beagleboard/capes/beaglebone/Comms/BeagleBoneCommsCapeA2_Top.png

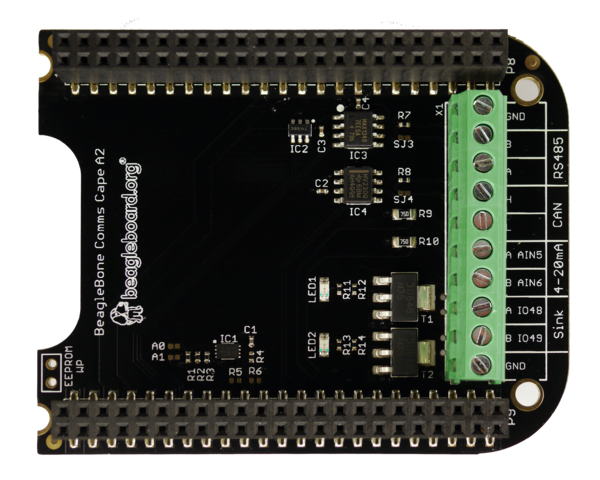
beaglebone/Comms/BeagleBoneCommsCapeA2_Top.png
