beagleboard/capes/README.md

| Cape | Manufacturer | Status |
|---|---|---|
| [Robotics](designs/Robotics) | Element14 | [production](http://beagleboard.org/RoboticsCape/) |
| [CAN_RS485](designs/CAN_RS485) | GHI Electronics | prototype |
| [Relay](designs/Relay) | GHI Electronics | prototype |
| [Load](designs/Load) | GHI Electronics | prototype |
| [Proto](designs/Proto) | GHI Electronics | prototype |
| [Power](designs/Power) | GHI Electronics | prototype |
| [Display18](designs/Display18) | GHI Electronics | prototype |
| [Display43](designs/Display43) | GHI Electronics | development |
| [Display70](designs/Display70) | GHI Electronics | development |
| [Motor](designs/Motor) | GHI Electronics | development |
