beagleboard/capes/beaglebone/Robotics/README.txt

This repository contains documentation of the physical Robotics Cape PCB design.

For instructions on using the support software and EduMiP, please visit:
https://beagleboard.org/librobotcontrol

Original source: https://github.com/StrawsonDesign/Robotics_Cape_Documentation
