beagleboard/capes/scripts/am335x-beagle-pins.csv

Board or signal detail | Manufacturer(s) | ID | Version | Addr | Status | Signal
[https://github.com/beagleboard/beaglebone-black BeagleBone Black] | Element14 / GHI Electronics | BNLT | 00C0 | 50 | [https://beagleboard.org/black production] | P8.01 / P8.02 / P9.01 / P9.02 / P9.43 / P9.44 / P9.45 / P9.46 | P8.03 / eMMC d6 | P8.04 / eMMC d7 | P8.05 / eMMC d2 | P8.06 / eMMC d3 | P8.07 | P8.08 | P8.09 | P8.10 | P8.11 | P8.12 | P8.13 | P8.14 | P8.15 | P8.16 | P8.17 | P8.18 | P8.19 | P8.20 / eMMC cmd | P8.21 / eMMC clk | P8.22 / eMMC d5 | P8.23 / eMMC d4 | P8.24 / eMMC d1 | P8.25 / eMMC d0 | P8.26 | P8.27 / hdmi | P8.28 / hdmi | P8.29 / hdmi | P8.30 / hdmi | P8.31 / hdmi / sysboot 14 | P8.32 / hdmi / sysboot 15 | P8.33 / hdmi / sysboot 13 | P8.34 / hdmi / sysboot 11 | P8.35 / hdmi / sysboot 12 | P8.36 / hdmi / sysboot 10 | P8.37 / hdmi / sysboot 8 | P8.38 / hdmi / sysboot 9 | P8.39 / hdmi / sysboot 6 | P8.40 / hdmi / sysboot 7 | P8.41 / hdmi / sysboot 4 | P8.42 / hdmi / sysboot 5 | P8.43 / hdmi / sysboot 2 | P8.44 / hdmi / sysboot 3 | P8.45 / hdmi / sysboot 0 | P8.46 / hdmi / sysboot 1 | P9.03 / P9.04 | P9.05 / P9.06 / VDD_5V | P9.07 / P9.08 / SYS_5V | P9.09 | P9.10 / -reset | P9.11 | P9.12 | P9.13 | P9.14
[https://github.com/beagleboard/beaglebone-black-wireless BeagleBone Black Wireless] | GHI Electronics | BNLT | BWA5 | 50 | [https://beagleboard.org/black-wireless production] | P8.01 / P8.02 / P9.01 / P9.02 / P9.43 / P9.44 / P9.45 / P9.46 | P8.03 / eMMC d6 | P8.04 / eMMC d7 | P8.05 / eMMC d2 | P8.06 / eMMC d3 | P8.07 | P8.08 | P8.09 | P8.10 | P8.11 | P8.12 | P8.13 | P8.14 | P8.15 | P8.16 | P8.17 | P8.18 | P8.19 | P8.20 / eMMC cmd | P8.21 / eMMC clk | P8.22 / eMMC d5 | P8.23 / eMMC d4 | P8.24 / eMMC d1 | P8.25 / eMMC d0 | P8.26 | P8.27 / hdmi | P8.28 / hdmi | P8.29 / hdmi | P8.30 / hdmi | P8.31 / hdmi / sysboot 14 | P8.32 / hdmi / sysboot 15 | P8.33 / hdmi / sysboot 13 | P8.34 / hdmi / sysboot 11 | P8.35 / hdmi / sysboot 12 | P8.36 / hdmi / sysboot 10 | P8.37 / hdmi / sysboot 8 | P8.38 / hdmi / sysboot 9 | P8.39 / hdmi / sysboot 6 | P8.40 / hdmi / sysboot 7 | P8.41 / hdmi / sysboot 4 | P8.42 / hdmi / sysboot 5 | P8.43 / hdmi / sysboot 2 | P8.44 / hdmi / sysboot 3 | P8.45 / hdmi / sysboot 0 | P8.46 / hdmi / sysboot 1 | P9.03 / P9.04 | P9.05 / P9.06 / VDD_5V | P9.07 / P9.08 / SYS_5V | P9.09 | P9.10 / -reset | P9.11 | P9.12 | P9.13 | P9.14
[https://github.com/beagleboard/beaglebone-blue BeagleBone Blue] | Element14 | BNLT | BLA2 | 50 | [https://beagleboard.org/blue production] | UT0_1 / UT1_1 / UT5_1 / CAN_1 / DSM2_2 / I2C_1 / GP0_1 / GP1_1 / GPS_2 / GPS_6 / S1.1_1 / S1.2_1 / E1_1 / E2_1 / E3_1 / E4_1 / PWR_1 / PWR_2 / GND | -eMMC_DAT6 | -eMMC_DAT7 | -eMMC_DAT2 | -eMMC_DAT3 | RED | GREEN | PAUSE | MODE | E3_4 / EQEP_2B | E3_3 / EQEP_2A | MPWM_4 | BAT100 | E4_4 | E4_3 | BAT25 |  | MPWM_3 | -eMMC_CMD | -eMMC_CLK | -eMMC_DAT5 | -eMMC_DAT4 | -eMMC_DAT1 | -eMMC_DAT0 | BAT75 | SERVO_1 | SERVO_2 | SERVO_3 | SERVO_4 |  | BAT50 | E2_4 / EQEP_1B | MDIR_2B | E2_3 / EQEP_1A | SERVO_PWR_EN | UT5_4 / UART5_TX | UT5_3 / UART5_RX | SERVO_5 | SERVO_6 | SERVO_7 | SERVO_8 | MDIR_3B | MDIR_3A | MDIR_4A | MDIR_4B | UT0_2 / UT1_2 / UT5_2 / CAN_2 / DSM2_1 / I2C_2 / GP0_2 / GP1_2 / S1.1_2 / S1.2_2 / E1_2 / E2_2 / E3_2 / E4_2 / PWR_3 / 3.3V |  | PWR_4 / GPS_5 / 5.0V | POWER_BTN | RESET | DSM_3 / UART4_RX |  | MDIR_1B | MPWM_1
[https://github.com/beagleboard/pocketbeagle PocketBeagle] | GHI Electronics | PBGL | 00A2 | 50 | [https://beagleboard.org/pocket production] | P1.15 / P1.16 / P1.22 / P2.15 / P2.21 / GND |  |  |  |  |  |  | EEPROM-WP / GPIO69 |  | P2.33 / GPIO45 | P2.24 / GPIO44 | P2.03 / GPIO23 | P1.34 / GPIO26 | P2.18 / GPIO47 | P2.22 / GPIO46 | P2.19 / GPIO27 | P2.17 / GPIO65 |  |  |  |  |  |  |  |  | P2.35 / AIN5 / GPIO86 | P1.35 / PRU1.10 | P1.02 / AIN6 / GPIO87 | P1.04 / PRU1.11 | sysboot 14 | sysboot 15 | sysboot 13 | sysboot 11 | sysboot 12 | sysboot 10 | sysboot 8 | sysboot 9 | sysboot 6 | sysboot 7 | sysboot 4 | sysboot 5 | sysboot 2 | sysboot 3 | sysboot 0 | sysboot 1 | P1.14 / P2.23 / VOUT-3.3V | P1.01 / VIN | P1.24 / P2.13 / VOUT-5V | P2.12 / POWER_BTN | P2.26 / NRESET | P2.05 / UART4_RX | P2.08 / GPIO60 | P2.07 / UART4_TX | P2.01 / PWM1A
[https://github.com/beagleboard/capes/blob/master/designs/Comms Comms Cape] | GHI Electronics | BBORG_COMMS | 00A2 | 56 | prototype | GND |  |  |  |  |  |  |  |  |  |  |  |  |  |  |  |  |  |  |  |  |  |  |  |  |  |  |  |  |  |  |  |  |  |  |  |  |  |  |  |  |  |  |  |  | VCC | +5 | SYS.VOUT |  |  | RS485.RX / UART4 RX | RS485.TX / UART4 TX
[https://github.com/beagleboard/capes/blob/master/designs/Display18 Display 1.8” Cape] | GHI Electronics | BBORG_DISPLAY18 | 00A2 | 57 | prototype | GND |  |  |  |  |  |  |  |  | LCD.DC | BTN1 | LED2 | BTN2 |  | BTN3 |  | BTN4 | LED1 |  |  |  |  |  |  | LCD.BACKLIGHT | LCD.RESET |  |  |  |  |  |  |  |  |  |  |  |  |  |  |  |  |  |  |  | VCC | +5
[https://github.com/beagleboard/capes/blob/master/designs/Display50 Display 5.0” Cape] | GHI Electronics | BBORG_DISPLAY50 | 00A2 | 57 | development | GND |  |  |  |  |  |  |  |  |  |  |  |  |  |  |  |  |  |  |  |  |  |  |  |  | LCD.VSYNC | LCD.CLK | LCD.HSYNC | LCD.DEN | LCD.R6 | LCD.R7 | LCD.R5 | LCD.R3 | LCD.R4 | LCD.G7 | LCD.G5 | LCD.G6 | LCD.G3 | LCD.G4 | LCD.B7 | LCD.G2 | LCD.B5 | LCD.B6 | LCD.B3 | LCD.B4 | VCC | VDD_5V | +5 |  |  |  |  |  | LCD.BACKLIGHT
[https://github.com/beagleboard/capes/blob/master/designs/Display70 Display 7.0” Cape] | GHI Electronics | BBORG_DISPLAY70 | 00A2 | 57 | development | GND |  |  |  |  |  |  |  |  |  |  |  |  |  |  |  |  |  |  |  |  |  |  |  |  | LCD.VSYNC | LCD.CLK | LCD.HSYNC | LCD.DEN | LCD.R6 | LCD.R7 | LCD.R5 | LCD.R3 | LCD.R4 | LCD.G7 | LCD.G5 | LCD.G6 | LCD.G3 | LCD.G4 | LCD.B7 | LCD.G2 | LCD.B5 | LCD.B6 | LCD.B3 | LCD.B4 | VCC | VDD_5V | +5 |  |  |  |  |  | LCD.BACKLIGHT
[https://github.com/beagleboard/capes/blob/master/designs/Load Load Cape] | GHI Electronics | BBORG_LOAD | 00A2 | 54 | prototype | GND |  |  |  |  |  |  |  |  | SINK6 | SINK5 |  |  | SINK7 |  | SINK8 |  |  |  |  |  |  |  |  |  |  |  |  |  |  |  |  |  |  |  |  |  |  |  |  |  |  |  |  |  | VCC |  |  |  |  |  | SINK3
[https://github.com/beagleboard/capes/blob/master/designs/Motor Motor Cape] | GHI Electronics | BBORG_MOTOR | 00A2 | 55 | development | GND |  |  |  |  | M2.HIGH | M1.HIGH | M3.HIGH | M4.HIGH |  |  | M3.PWM2.B |  |  |  |  |  | M4.PWM2.A |  |  |  |  |  |  |  |  |  |  |  |  |  |  |  |  |  |  |  |  |  |  |  |  |  |  |  | VCC | +5 | SYS.VOUT |  |  |  |  |  | M2.PWM1.A
[https://github.com/beagleboard/capes/blob/master/designs/Power Power Cape] | GHI Electronics | BBORG_POWER | 00A2 | N/A | prototype | GND |  |  |  |  |  |  |  |  |  |  |  |  |  |  |  |  |  |  |  |  |  |  |  |  |  |  |  |  |  |  |  |  |  |  |  |  |  |  |  |  |  |  |  |  | VCC | +5 | SYS.VOUT | PWR.BTN | SYS.RESET#
[https://github.com/beagleboard/capes/blob/master/designs/Proto Proto Cape] | GHI Electronics | BBORG_PROTO | 00A2 | 54 | prototype | GND |  |  |  |  |  |  |  |  |  |  |  |  |  |  |  |  |  |  |  |  |  |  |  |  |  |  |  |  |  |  |  |  |  |  |  |  |  |  |  |  |  |  |  |  | VCC
[https://github.com/beagleboard/capes/blob/master/designs/Relay Relay Cape] | GHI Electronics | BBORG_RELAY | 00A2 | 54 | prototype | GND |  |  |  |  |  |  |  |  |  |  |  |  |  |  |  |  |  |  |  |  |  |  |  |  |  |  |  |  |  |  |  |  |  |  |  |  |  |  |  |  |  |  |  |  | VCC |  | +5
[https://github.com/beagleboard/capes/blob/master/designs/Robotics Robotics Cape] | Element14 | BBORG_ROBOTICS |  |  | [http://beagleboard.org/RoboticsCape/ production] | GND |  |  |  |  | RED | GREEN | PAUSE | MODE | QEP_2B | QEP_2A | PWM_2B | LED_4 | QEP_4B | QEP_4A | LED_1 | LED_2 | PWM_2A |  |  |  |  |  |  | LED_3 | SVO1 | SVO2 | SVO3 | SVO4 |  |  | QEP_1B | MDIR_2B | QEP_1A | SERVO_EN | UART5_TX | UART5_RX | SVO5 | SVO6 | SVO7 | SVO8 | MDIR_3B | MDIR_3A | MDIR_4A | MDIR_4B | 3.3V | 5.0V | SYS_5V | PWR | RESET | UART4_RX | MDIR_1A | MDIR_1B | PWM_1A
Servo Cape | GHI Electronics | BBORG_SERVO |  | 55 | development
ZCZ/BSP ball |  |  |  |  |  |  | R9 | T9 | R8 | T8 | R7 | T7 | T6 | U6 | R12 | T12 | T10 | T11 | U13 | V13 | U12 | V12 | U10 | V9 | U9 | V8 | U8 | V7 | U7 | V6 | U5 | V5 | R5 | R6 | V4 | T5 | V3 | V3 | V2 | U3 | U1 | U2 | T3 | T4 | T1 | T2 | R3 | R4 | R1 | R2 |  |  |  |  | A10 | T17 | U18 | U17 | U14
BSM ball |  |  |  |  |  |  | P4 | R4 | R1 | T3 | M1 | N1 | N3 | N2 | R6 | P6 | P5 | R5 | P7 | T6 | T5 | T7 | T4 | P1 | P2 | T1 | T2 | R2 | R3 | P3 | F3 | F1 | F2 | E1 | L1 | M3 | L2 | K1 | L3 | K2 | J1 | K3 | J3 | J2 | H2 | H1 | G1 | H3 | G3 | G2 |  |  |  | T11 | R11 | P15 | N14 | R16 | P12
Control register |  |  |  |  |  |  | 818 | 81C | 808 | 80C | 890 | 894 | 89C | 898 | 834 | 830 | 824 | 828 | 83C | 838 | 82C | 88C | 820 | 884 | 880 | 814 | 810 | 804 | 800 | 87C | 8e0 | 8e8 | 8e4 | 8EC | 8D8 | 8DC | 8D4 | 8CC | 8D0 | 8C8 | 8C0 | 8C4 | 8B8 | 8BC | 8B0 | 8B4 | 8A8 | 8AC | 8A0 | 8A4 |  |  |  |  | 9B8 | 870 | 878 | 874 | 848
Mux mode 0 |  |  |  |  |  | GND | gpmc d6 | gpmc d7 | gpmc d2 | gpmc d3 | gpmc adv/ale | gpmc oe/re | gpmc be0/cle | gpmc we | gpmc d13 | gpmc d12 | gpmc d9 | gpmc d10 | gpmc d15 | gpmc d14 | gpmc d11 | gpmc clk | gpmc d8 | gpmc cs 2 | gpmc cs 1 | gpmc d5 | gpmc d4 | gpmc d1 | gpmc d0 | gpmc cs 0 | lcd vsync | lcd pclk | lcd hsync | lcd oe/acb | lcd d14 | lcd d15 | lcd d13 | lcd d11 | lcd d12 | lcd d10 | lcd d8 | lcd d9 | lcd d6 | lcd d7 | lcd d4 | lcd d5 | lcd d2 | lcd d3 | lcd d0 | lcd d1 | VOUT-3.3V | VIN | VOUT-5V | POWER | reset in/out | gpmc wait 0 | gpmc be1 | gpmc wp | gpmc a2
Mux mode 1 |  |  |  |  |  |  | mmc 1 d6 | mmc 1 d7 | mmc 1 d2 | mmc 1 d3 | - | - | - | - | lcd d18 | lcd d19 | lcd d22 | lcd d21 | lcd d16 | lcd d17 | lcd d20 | lcd mclk | lcd d23 | gpmc be1 | gpmc clk | mmc 1 d5 | mmc 1 d4 | mmc 1 d1 | mmc 1 d0 | - | gpmc a8 | gpmc a10 | gpmc a9 | gpmc a11 | gpmc a18 | gpmc a19 | gpmc a17 | gpmc a15 | gpmc a16 | gpmc a14 | gpmc a12 | gpmc a13 | gpmc a6 | gpmc a7 | gpmc a4 | gpmc a5 | gpmc a2 | gpmc a3 | gpmc a0 | gpmc a1 |  |  |  |  | - | mii 1 crs | mii 1 col | mii 1 rxer | mii 1 txd3
Mux mode 2 |  |  |  |  |  |  | - | - | - | - | timer 4 | timer 7 | timer 5 | timer 6 | mmc 1 d5 | mmc 1 d4 | mmc 1 d1 | mmc 1 d2 | mmc 1 d7 | mmc 1 d6 | mmc 1 d3 | gpmc wait 1 | mmc 1 d0 | mmc 1 cmd | mmc 1 clk | - | - | - | - | - | gpmc a1 | pru mii 0 crs | gpmc a2 | pru mii 1 crs | qep 1 index | qep 1 strobe | qep 1 in B | pwm 1 out B | qep 1 in A | pwm 1 out A | pwm 1 tripzone | pwm sync out | pru edio in 6 | pru edio in 7 | pru mii 0 txd1 | pru mii 0 txd0 | pru mii 0 txd3 | pru mii 0 txd2 | pru mii 0 txclk | pru mii 0 txen |  |  |  |  | - | gpmc cs 4 | gpmc cs 6 | gpmc cs 5 | rgmii 1 txd3
Mux mode 3 |  |  |  |  |  |  | - | - | - | - | - | - | - | - | mmc 2 d1 | mmc 2 d0 | mmc 2 d5 | mmc 2 d6 | mmc 2 d3 | mmc 2 d2 | mmc 2 d7 | mmc 2 clk | mmc 2 d4 | pru edio in 7 | pru edio in 6 | - | - | - | - | - | pru edio in 2 | pru edio in 4 | pru edio in 3 | pru edio in 5 | asp 0 data 1 | asp 0 tx hclk | asp 0 rx fs | asp 0 rx hclk | asp 0 rx clk | asp 0 data 0 | asp 0 tx clk | asp 0 tx fs | qep 2 index | qep 2 strobe | qep 2 in A | qep 2 in B | pwm 2 tripzone | pwm sync out | pwm 2 out A | pwm 2 out B |  |  |  |  | - | rmii 1 crs/rxdv | mmc 2 d3 | rmii 1 rxer | mmc 2 d1
Mux mode 4 |  |  |  |  |  |  | - | - | - | - | - | - | - | - | qep 2 in B | qep 2 in A | pwm 2 out B | pwm 2 tripzone | qep 2 strobe | qep 2 index | pwm sync out | pru mii 1 crs | pwm 2 out A | pru edio out 7 | pru edio out 6 | - | - | - | - | - | pru edio out 2 | pru edio out 4 | pru edio out 3 | pru edio out 5 | uart 5 rxd | asp 0 data 3 | asp 0 data 3 | asp 0 data 2 | asp 0 data 2 | - | uart 5 txd | uart 5 rxd | pru edio out 6 | pru edio out 7 | - | - | - | - | - | - |  |  |  |  | - | mmc 1 cd | gpmc dir | mmc 2 cd | gpmc a18
Mux mode 5 |  |  |  |  |  |  | - | - | - | - | - | - | - | - | pru mii 0 txd1 | pru mii 0 txd2 | pru mii 0 col | pru mii 0 txen | pru eCAP | pru mii 0 txd0 | pru mii 0 txd3 | pru mdio clock | pru mii 0 txclk | pru 1 out 13 | pru 1 out 12 | - | - | - | - | - | pru 1 out 8 | pru 1 out 10 | pru 1 out 9 | pru 1 out 11 | pru mii 0 rxclk | pru mii 0 rxdv | pru mii 0 rxer | pru mii 0 rxd0 | pru mii 0 rxlink | pru mii 0 rxd1 | pru mii 0 rxd3 | pru mii 0 rxd2 | pru 1 out 6 | pru 1 out 7 | pru 1 out 4 | pru 1 out 5 | pru 1 out 2 | pru 1 out 3 | pru 1 out 0 | pru 1 out 1 |  |  |  |  | - | pru mii 1 col | pru mii 1 rxlink | pru mii 1 txen | pru mii 1 txd2
Mux mode 6 |  |  |  |  |  |  | - | - | - | - | - | - | - | - | pru 0 out 15 | pru 0 out 14 | - | - | pru 0 in 15 | pru 0 in 14 | - | asp 0 rx fs | - | pru 1 in 13 | pru 1 in 12 | - | - | - | - | - | pru 1 in 8 | pru 1 in 10 | pru 1 in 9 | pru 1 in 11 | uart 5 cts | uart 5 rts | uart 4 rts | uart 3 rts | uart 4 cts | uart 3 cts | uart 2 cts | uart 2 rts | pru 1 in 6 | pru 1 in 7 | pru 1 in 4 | pru 1 in 5 | pru 1 in 2 | pru 1 in 3 | pru 1 in 0 | pru 1 in 1 |  |  |  |  | - | uart 4 rxd | asp 0 rx clk | uart 4 txd | pwm 1 out A
Mux mode 7 |  |  |  |  |  |  | gpio 1.06 | gpio 1.07 | gpio 1.02 | gpio 1.03 | gpio 2.02 | gpio 2.03 | gpio 2.05 | gpio 2.04 | gpio 1.13 | gpio 1.12 | gpio 0.23 | gpio 0.26 | gpio 1.15 | gpio 1.14 | gpio 0.27 | gpio 2.01 | gpio 0.22 | gpio 1.31 | gpio 1.30 | gpio 1.05 | gpio 1.04 | gpio 1.01 | gpio 1.00 | gpio 1.29 | gpio 2.22 | gpio 2.24 | gpio 2.23 | gpio 2.25 | gpio 0.10 | gpio 0.11 | gpio 0.09 | gpio 2.17 | gpio 0.08 | gpio 2.16 | gpio 2.14 | gpio 2.15 | gpio 2.12 | gpio 2.13 | gpio 2.10 | gpio 2.11 | gpio 2.08 | gpio 2.09 | gpio 2.06 | gpio 2.07 |  |  |  |  | - | gpio 0.30 | gpio 1.28 | gpio 0.31 | gpio 1.18
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
