beagleboard/capes/beaglebone/Robotics/models/SD-101D Robotics Cape 3D Model.SLDPRT

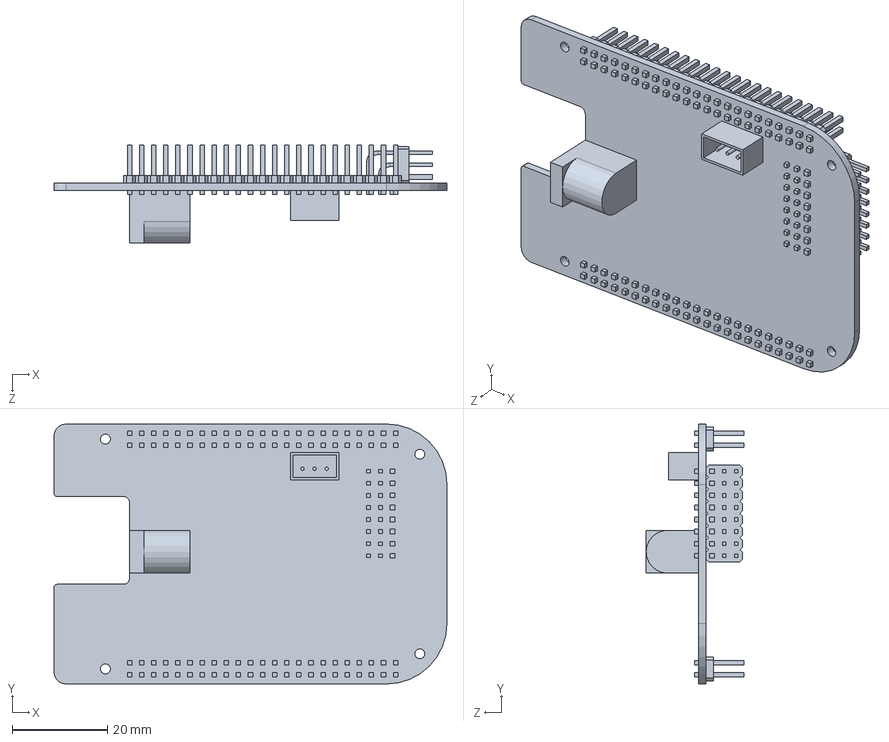
[picture p2: CAD file, 2017-10-18]
beaglebone/Robotics/models/SD-101D Robotics Cape 3D Model.SLDPRT
82.6 x 54.6 x 20.5 mm
