beagleboard/capes/beaglebone/Relay/ISSUES.md

* Consider moving RELAY3 to avoid disrupting HDMI audio.
* Consider moving RELAY1 to avoid conficty with all display capes.
