beagleboard/capes/beaglebone/Display70/ISSUES.md

* How is WAKE used?
* Consider moving CAP.TOUCH.IRQ to the GPIO0 bank to enable wake-up.
* Consider moving CAP.TOUCH.IRQ to avoid Display18 Cape SPI1 utilization.
* Will running LCD.BACKLIGHT with a PWM will cause issues?
* Can we get some buttons added to make it feature complete with previous 7" display?
