beagleboard/capes/beaglebone/Comms/ISSUES.md

* Consider moving SINK.A to a pin that doesn't interfere with HDMI audio.
