beagleboard/capes/beaglebone/Display18/ISSUES.md

* Consider using SPI0 to avoid blocking HDMI audio.
* Where are the extra 4 buttons?
* Consider moving LCD.BACKLIGHT to a pin with PWM.
* Consider moving LCD.RESET to avoid blocking HDMI.
