beagleboard/capes/beaglebone/Load/ISSUES.md

* Consider moving SINK5 and SINK8 to avoid conflicts with Display18 Cape.
* Consider moving SINK3 to avoid conflict with CAN/RS485 Cape.
* Consider moving SINK2 to avoid conflict with all Display capes.
