beagleboard/capes/(threads)

Thread 3 (2018-09-12):

comms cape documentation is missing

jpearcy, 2018-09-12:
The comms cape documentation is missing files. See:
https://github.com/beagleboard/capes/tree/master/beaglebone/designs/Comms

silver2row, 2018-11-19:
Hello,

Number Six here: https://github.com/beagleboard/capes/blob/master/scripts/am335x-beagle-pins.csv.

...

I know it is not a schematic but it will show which pins are used to handle the Cape.

Seth

bpayne7, 2023-04-22:
Could you kindly inform me if the 3D CAD for the comms cape has been stored in any particular location?

Thread 4 (2018-11-10):

RE: The LoadCape and Docs.pdf or schematic.pdf...

silver2row, 2018-11-10:
Hello Sir,

Um...whenever you have time, please add some .pdf schematics of this bad-to-the-bone LoadCape.

Seth

P.S. Thank you for your time.

silver2row, 2018-11-14:
Hello Once More,

Seth here. I was trying to make this LoadCape work. I am not well informed on sinks as is. I keep reading about them when I have time.

...

Is there a snippet to start, e.g. Adafruit_BBIO. If not, that is okay. I will keep searching for current sinks and see what I can derive.

Seth

P.S. If you ever find time, please try to establish a working .pdf of the this Cape. Thank you again, sir/ma'am.

silver2row, 2018-11-16:
Hello,

I got some help from someone on the mfg. forums site. I am closing this issue.

Seth

RyanBishop545, 2018-12-15:
silver2row could you please give a link to the information you have found?

Closed 2018-11-16.

Thread 5 (2018-11-26):

GamePup support

jadonk, 2018-11-26:
* Final schematics, design and BOM
* Audio
* Charging
* ADVMAME setup

Hacksore, 2019-07-21:
@jadonk Trying to integrate with the gamepup but having a hard time in getting it working (primarily the display). Would you have some time to help me get off the ground here?

Any help is appreciated!

CoolGames, 2019-08-07:
LCD now working with only overlay applied as per
https://github.com/beagleboard/pocketbeagle/wiki/GamePup-cape

I have traced a staging driver issue in kernel 4.14.108-ti-r113 of reversed RED and Green to https://github.com/beagleboard/linux/blob/4.14/drivers/staging/fbtft/fb_st7735r.c
signal
MADCTL fixed in Adafruit version of pin 15 SRGB on based on page 15 of
https://cdn-shop.adafruit.com/datasheets/ST7735R_V0.2.pdf

issue is addressed near line 241
https://github.com/adafruit/Adafruit-ST7735-Library/blob/master/Adafruit_ST7735.cpp

Hacksore, 2019-08-07:
@CoolGames Lee thanks for digging into this, I know we've been going back and fourth on email regarding this.

Do you think that this kernel driver issue is my root cause of not being able to get the display working?

CoolGames, 2019-08-08:
I am viewing the YouTube videos about PocketBeagle and see where problem for me occurs.
You should see a boot screen with the above IMG and
instructions to add overlay to uEnv.txt.
If that fails then yes there may be a problem.
I used fbi then fbgrab and colors were intact so issue is hardware on pin 15
mentioned above.
I plan to attack after I learn how to repair the kernel module by viewing the videos.
I have a SLACK channel at Beagle dev site but no one is responding as they are busy with other projects before GamePup.
You should check with Jason to see if you can be added and then I can share the private channel there.
I am all over the place trying to find a path to GamePup using TechLab training with Beaglebone AI testing image on the TechLab cape.
I only have one Pocket Beagle and I do some kludges that may not be popular to share publicly.
We can keep documenting the issue here as well I think.

Thread 6 (2019-09-19):

question to @jadonk jadonk; about the USB A port

yxmagithub, 2019-09-19:
Can I use the USB A port on the techlab cape board to control outside USB client device, say, I want to control a RF module.

If so, How?

TechLabUSB A port-<-->> USB client B port

Thanks

jadonk, 2020-01-09:
yes, the type A is a standard USB host.

Closed 2025-05-01.

Thread 7 (2020-01-14):

TechLab_Cape_sch.pdf

ikarso, 2020-01-14:
Socket P1 the label for pin p1.31 has label P1.33/PRU0.4(ACC_INT2) -> P1.31/PRU0.4(ACC_INT2)

The same error at U3 MMA8453Q pin 9.

Thread 8 (2020-03-07):

TechCape Serial to USB problem

alanc98, 2020-03-07:
I have a pocket beagle and a techcape, and I am trying to get the USB serial device working.

 First of all, when I plug in a micro-usb cable to the techcape USB/serial connector, should the device show up on the host computer? I made sure I had a cable that works with data and not just as a charging cable. When I plug it in to either linux or windows, I dont get anything. Should I expect to see /dev/ttyUSB0 in my linux host for example?

As an example, I have other USB/serial devices, and they just show up as /dev/ttyUSB0 when I plug the USB into the host.

I also downloaded the techcape image for the pocket beagle, booted and logged in through the Pocket beagle gadget serial port..  should the USB/serial port be active by then?

Any device tree overlays needed to get it to work?

Thanks!

Thread 10 (2021-02-26):

Conflicting comms cape header pins information for RS485

jeettrivedi, 2021-02-26:
While scrolling through the Beagle Cape Header Pins  [spreadsheet](https://docs.google.com/spreadsheets/d/1fE-AsDZvJ-bBwzNBj1_sPDrutvEvsmARqFwvbw_HkrE/edit#gid=1518010293), I noticed that `RS485.TX/UART4 TX` has been incorrectly mapped to P9.12 instead of P9.13 (as shown in the [schematic](https://github.com/beagleboard/capes/blob/master/beaglebone/Comms/Comms_Cape_sch.pdf)).

Its a simple enough of a fix but I figured I would bring it to the attention of the maintainers so that it is rectified. I'm happy to make a pull request with the correction.

jadonk, 2021-07-05:
@jeettrivedi I don't see anywhere it is mapped to P9.12. Can you be more explicit? It seems all the documentation shows P9.11 for RX and P9.13 for TX.

jeettrivedi, 2021-07-05:
@jadonk I just checked and it seems that the mistake has been corrected in the [spreadsheet](https://docs.google.com/spreadsheets/d/1fE-AsDZvJ-bBwzNBj1_sPDrutvEvsmARqFwvbw_HkrE/edit#gid=1518010293). I will close this issue now. Thanks for bringing this to my attention.

Closed 2021-07-05.

Thread 12 (2022-07-22):

UART4 RX pin pulled low permanently

mzawodniok, 2022-07-22:
I have two boards that I tried to use for RS485. Both have similar issue with RX on UART4 being permanently pulled low. I monitored the RS485 signal as well as the RX from the MAX13487 - both have signal coming through, but the buffer (IC2) does not pass anything through, IC2's output pin is always low.

I believe based on my measurements that the IC2 buffer chip is faulty, but what is troubling it the same case on two boards.

Here is an oscilloscope screenshot of input (yellow) and output (green) pins on the IC2 (buffer gate).
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

UPDATE:
After some digging through the datasheets, the actual signal from MAX seems to be only 0-2V (peak-to-peak). Which would be too low for Schmidt trigger to work (switch high on output).... now question is why the MUX out is not higher??

mzawodniok, 2022-07-26:
Figured it out ... as expected it was so simple :) The board uses VDD_5V which is delivered from the external (barrel) power connector AND NOT from the USB power (as I've used it initially connected to a PC). Lesson learned for future.

Closed 2022-07-26.

Thread 16 (2025-05-05):

TechLab: improper location for board/version

jadonk, 2025-05-05:
The BeagleBoard.org logo goes where "PocketBeagle TechLab A5" was placed.

We need a process to add the logo automatically to produce the production release outside of materials in the public repository, perhaps applied in a private CI step.

Also, the serial connector doesn't have the same look-and-feel with regards to the silkscreen.

Further, none of the anticipated notes were added to the silkscreen.

Thread 17 (2025-05-05):

TechLab: bad reference designator updates

jadonk, 2025-05-05:
Schematic and layout reference designators are no longer aligned.

jadonk, 2025-05-05:
C7 in schematic is 4.7uF, but is 10uF in the PCB.

Closed 2025-05-14.
