beagleboard/capes/pocketbeagle/Grove/Grove_Cape_sch.pdf

DATE | REVISION | DESCRIPTION
02 | Grove / EEPROM / Power / LCD

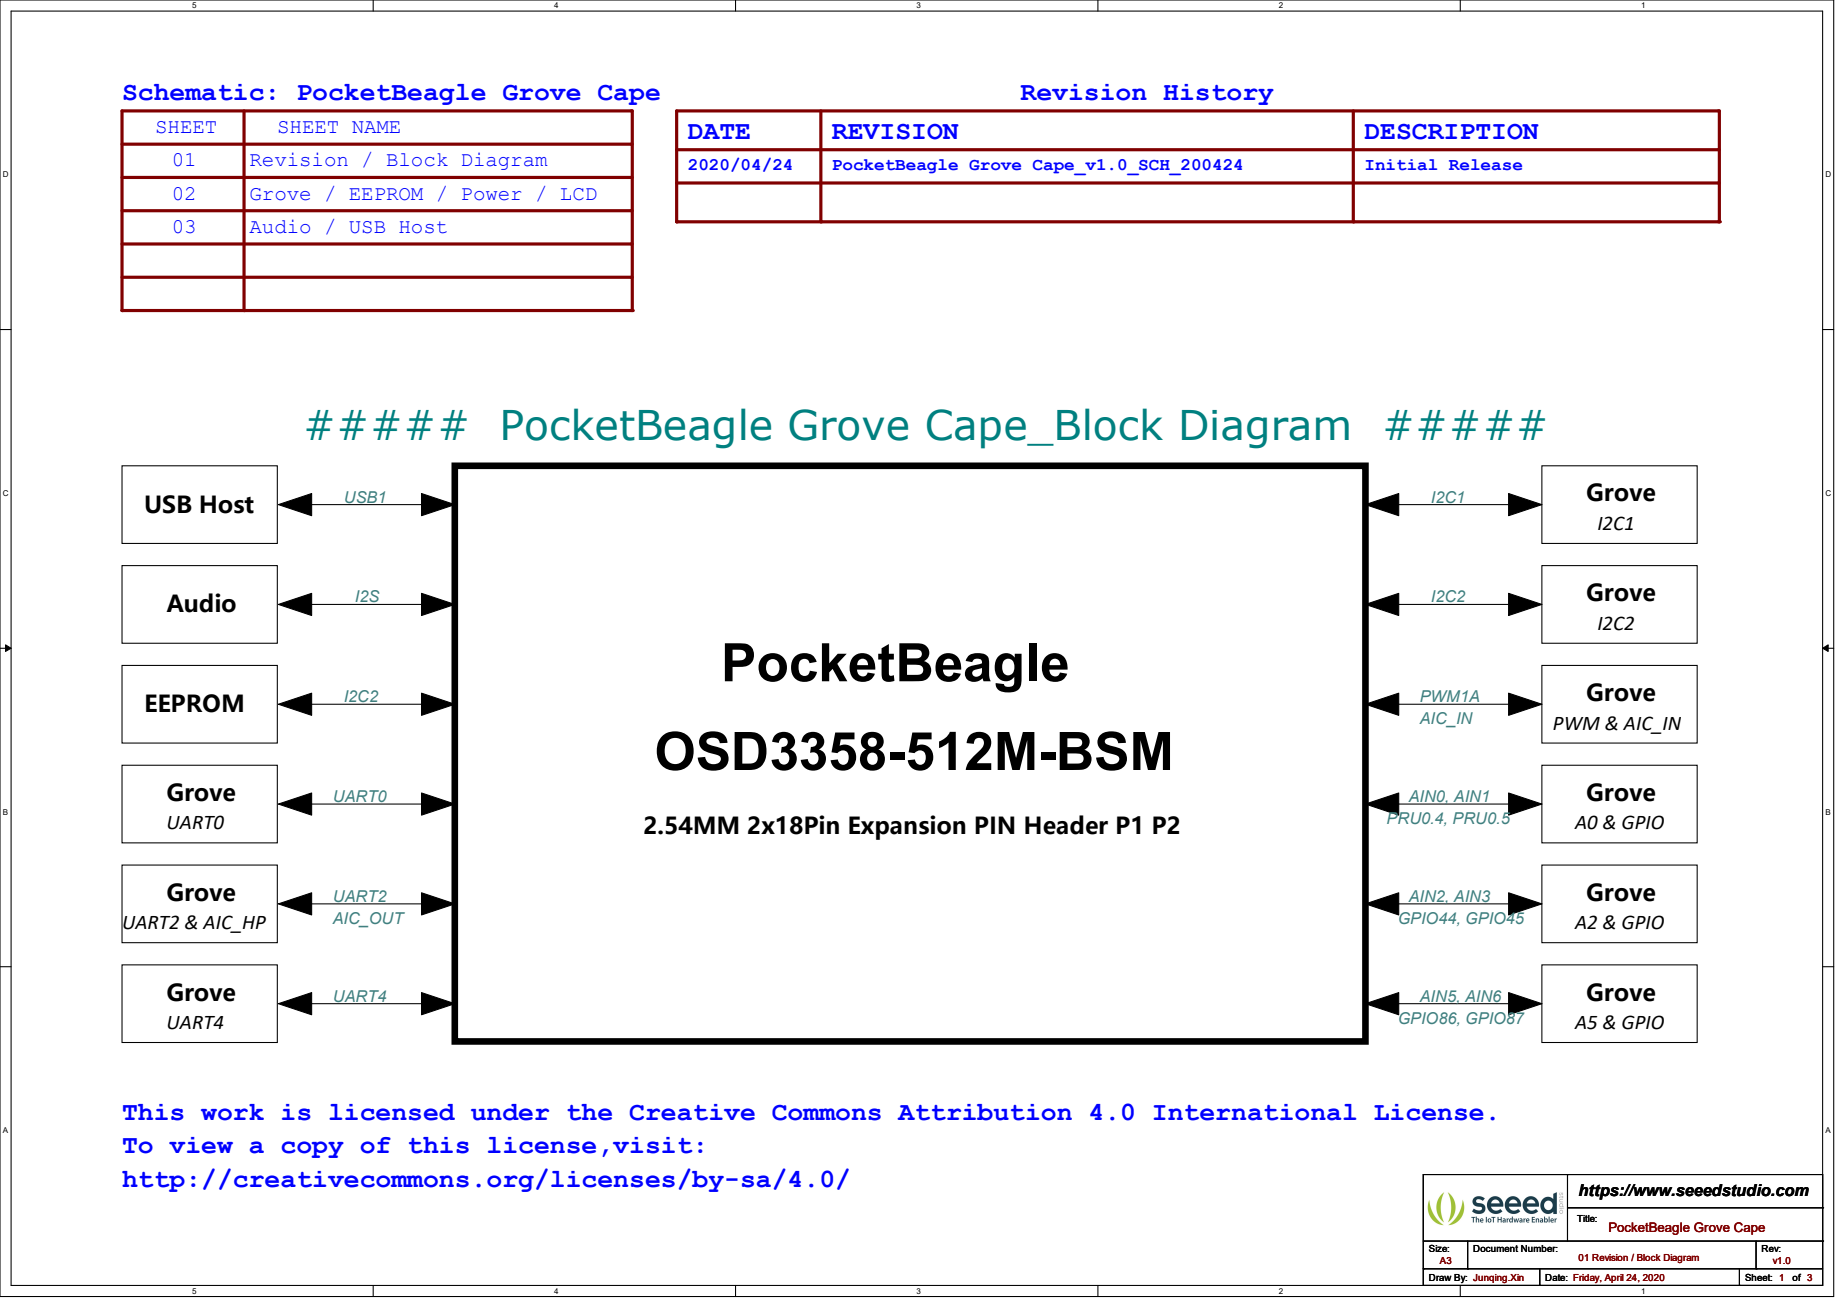
[picture p3: page 1]
SHEET NAME; Initial Release; Revision History; PocketBeagle Grove Cape_v1.0_SCH_200424; PocketBeagle; PWM1A; A0 & GPIO; Grove; PWM & AIC_IN; A2 & GPIO; AIN2, AIN3; A5 & GPIO; OSD3358-512M-BSM; UART2; UART0; USB1; UART4; Grove UART2 & AIC_HP; EEPROM; USB Host; Audio; AIC_OUT; AIC_IN; GPIO44, GPIO45; PRU0.4, PRU0.5; AIN0, AIN1; AIN5, AIN6 GPIO86, GPIO87; http://creativecommons.org/licenses/by-sa/4.0/; Title: Size:; Document Number:; Rev: Draw By:; Date:; Sheet:; https://www.seeedstudio.com A3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

Schematic: PocketBeagle Grove Cape
SHEET
01 Revision / Block Diagram

03 Audio / USB Host

##### PocketBeagle Grove Cape_Block Diagram #####

2.54MM 2x18Pin Expansion PIN Header P1 P2

This work is licensed under the Creative Commons Attribution 4.0 International License.
To view a copy of this license,visit:

PocketBeagle Grove Cape 01 Revision / Block Diagram

# DCDC 3.3V

R0402 R29

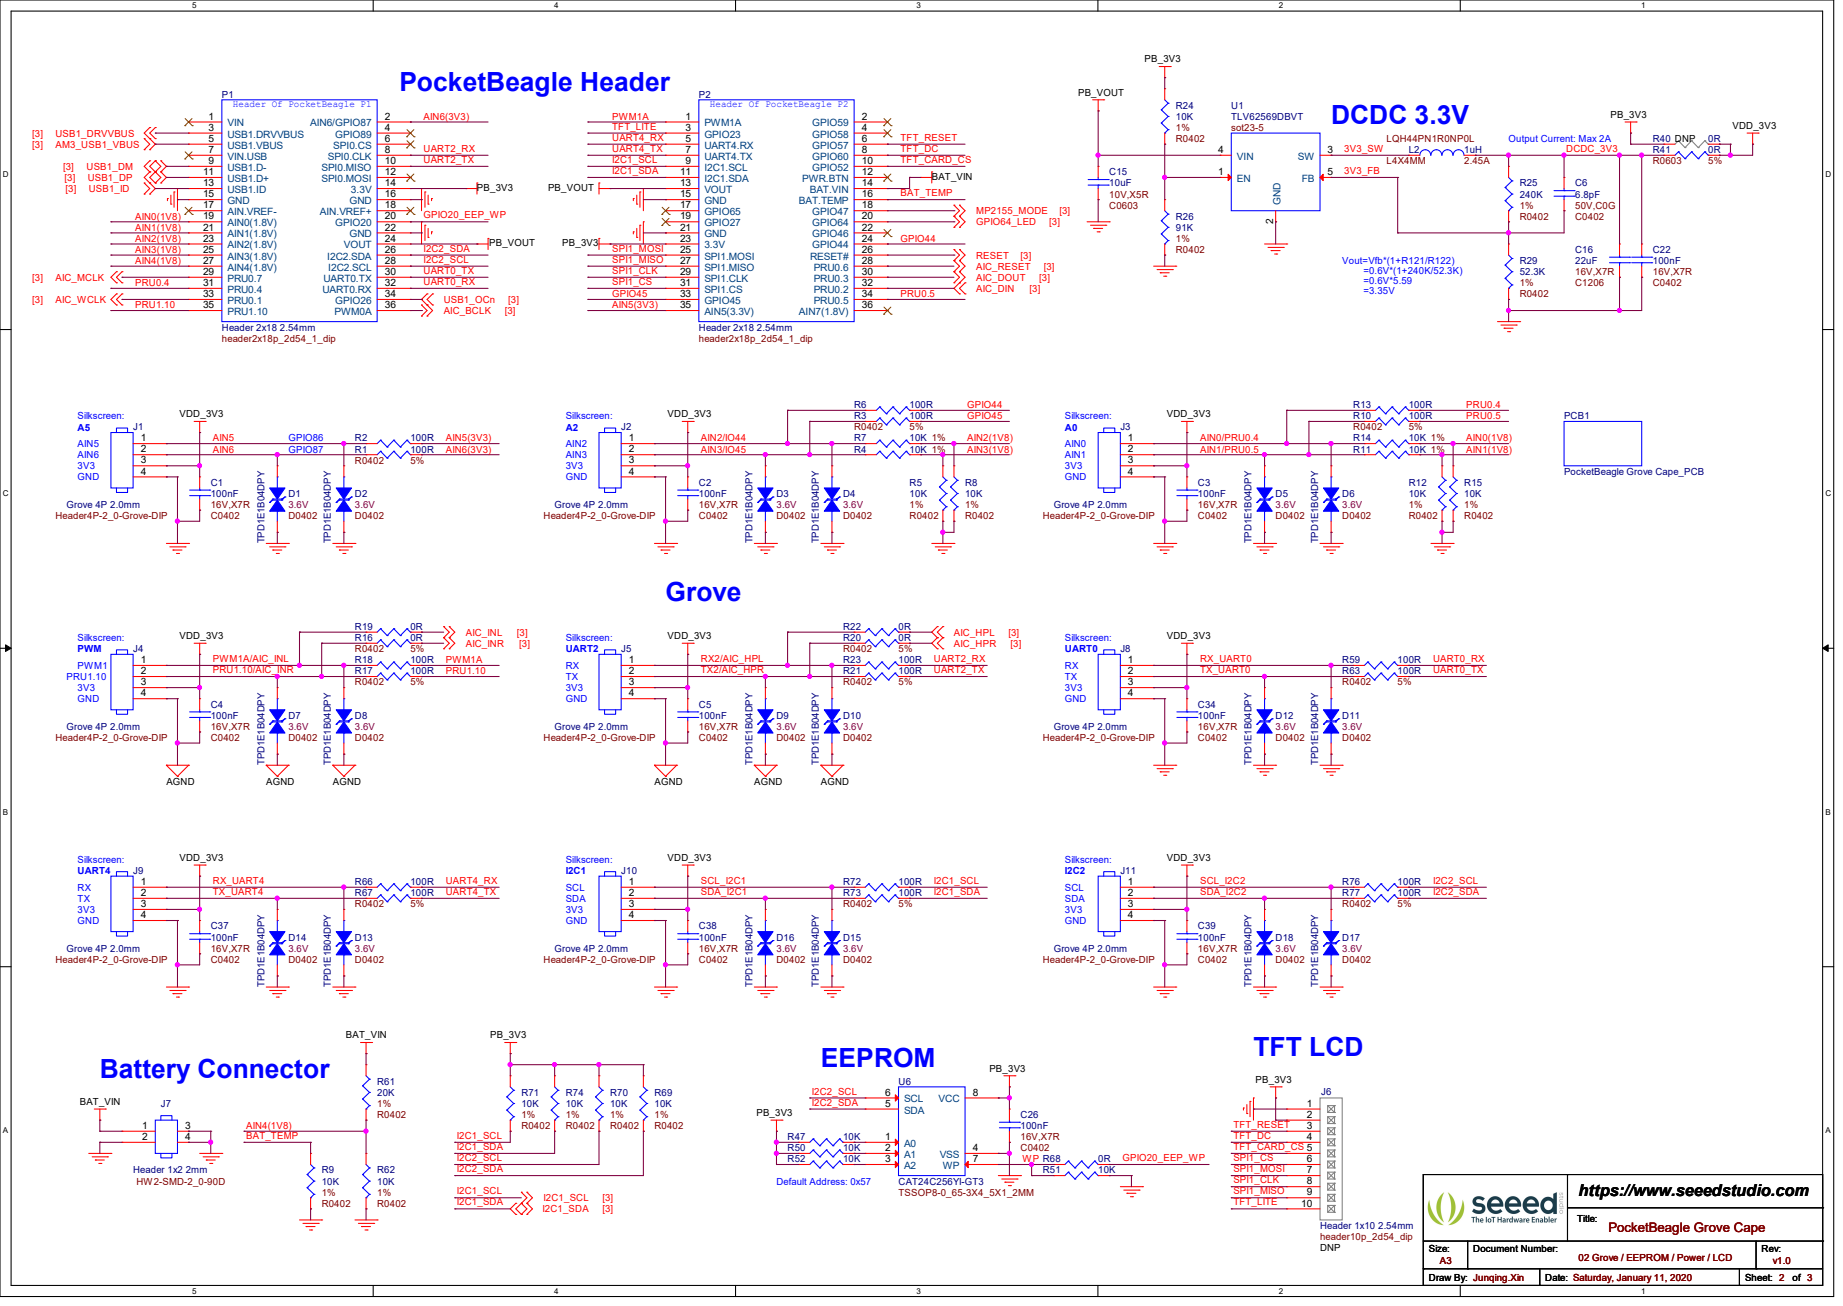
[picture p4: page 2]

PocketBeagle Grove Cape 02 Grove / EEPROM / Power / LCD

Battery LED | 3.3V AGND

# U3 TLV320AIC3104

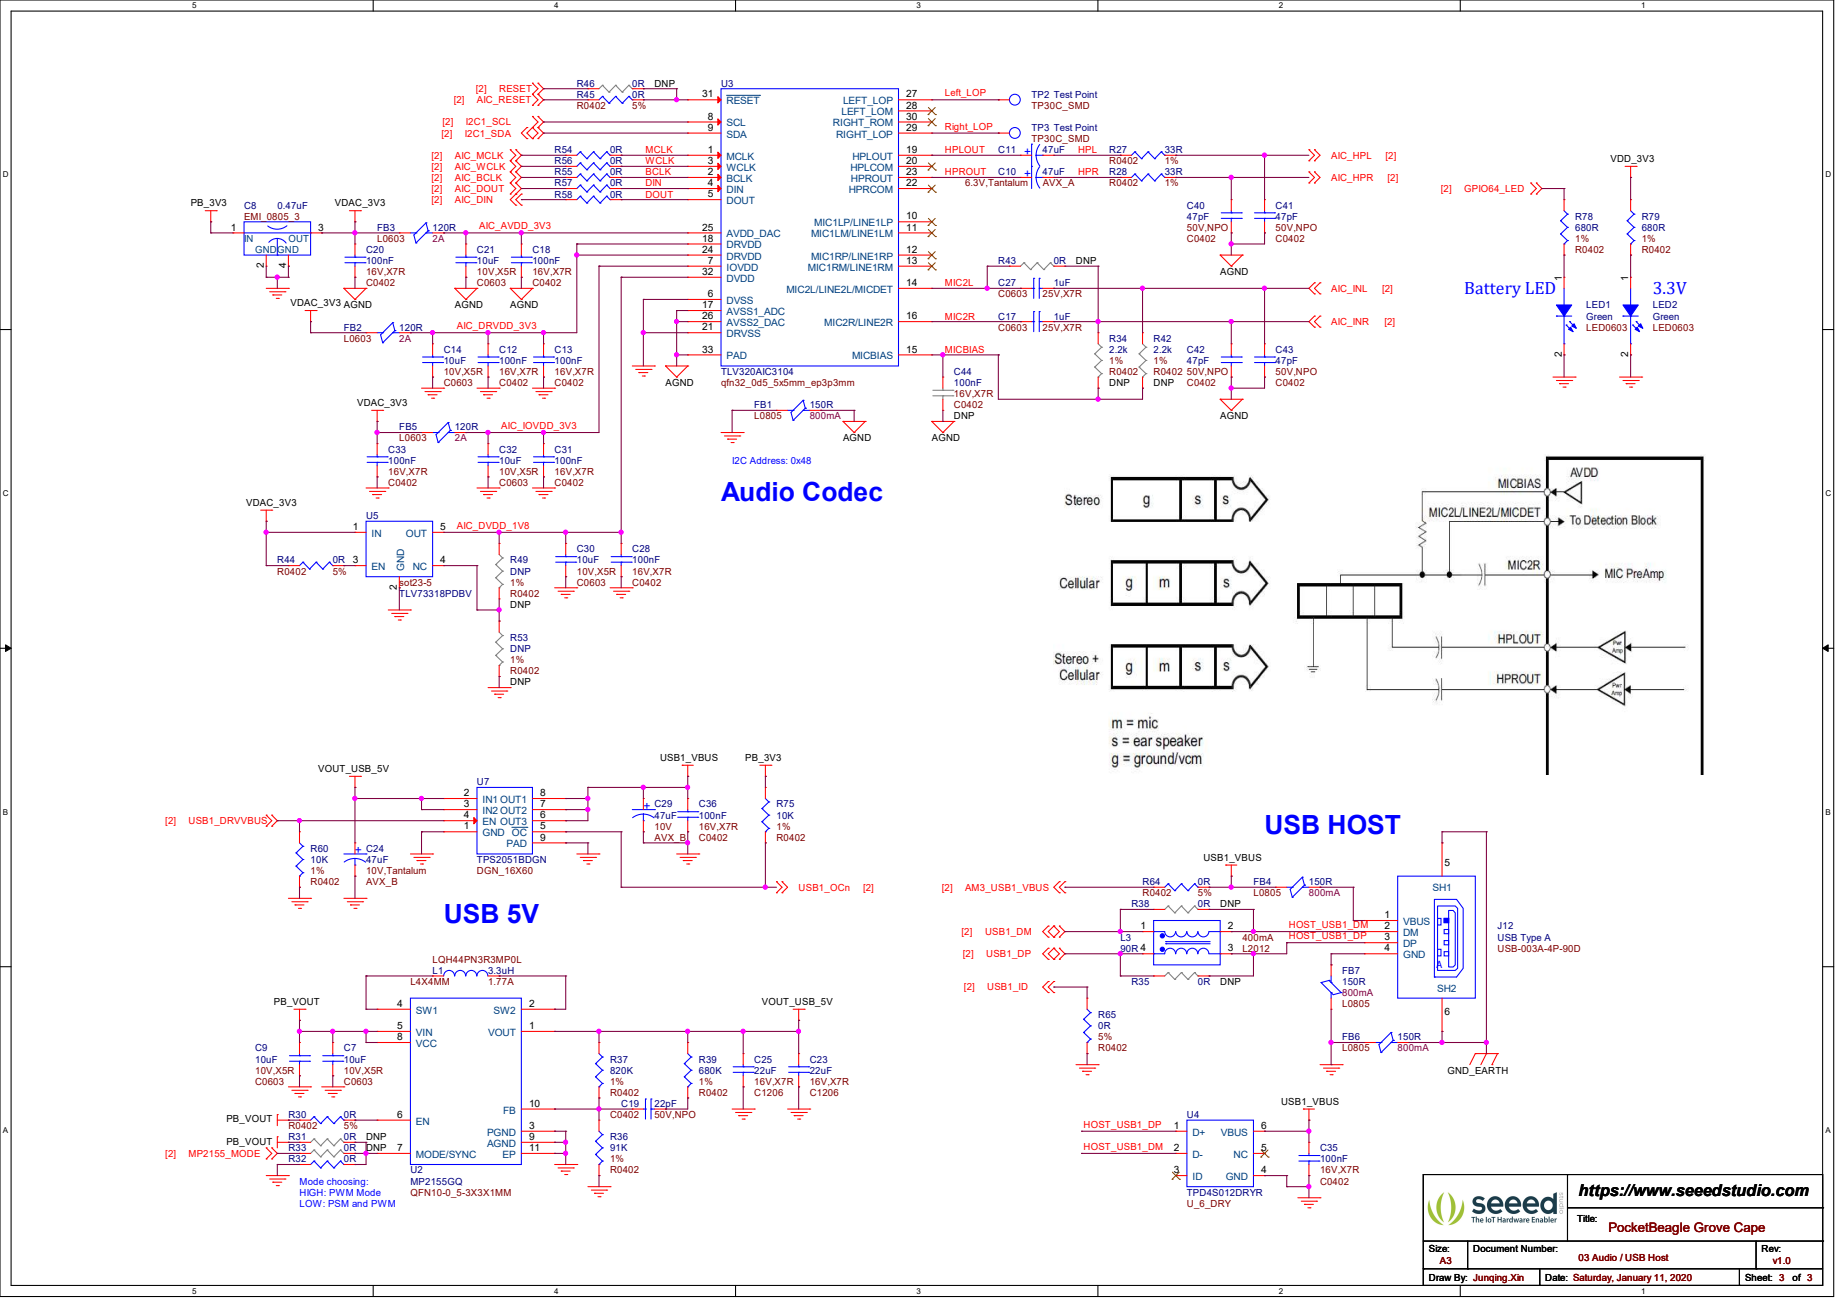
[picture p5: page 3]

RESET 31 SCL 8 SDA 9 MCLK 1 WCLK 3 BCLK 2 DIN 4 DOUT 5
LEFT_LOM 28 RIGHT_LOP 29 RIGHT_ROM 30 HPLOUT 19 HPROUT 23 HPRCOM 22 HPLCOM 20 MIC2R/LINE2R 16 MICBIAS 15 MIC2L/LINE2L/MICDET 14 MIC1LP/LINE1LP 10 MIC1LM/LINE1LM 11 MIC1RP/LINE1RP 12 MIC1RM/LINE1RM 13 AVDD_DAC 25 DRVDD 18

USB 5V Mode choosing: LOW: PSM and PWM

PocketBeagle Grove Cape 03 Audio / USB Host
