beagleboard/capes/pocketbeagle/GamePup/GamePup_Cape_brd.pdf

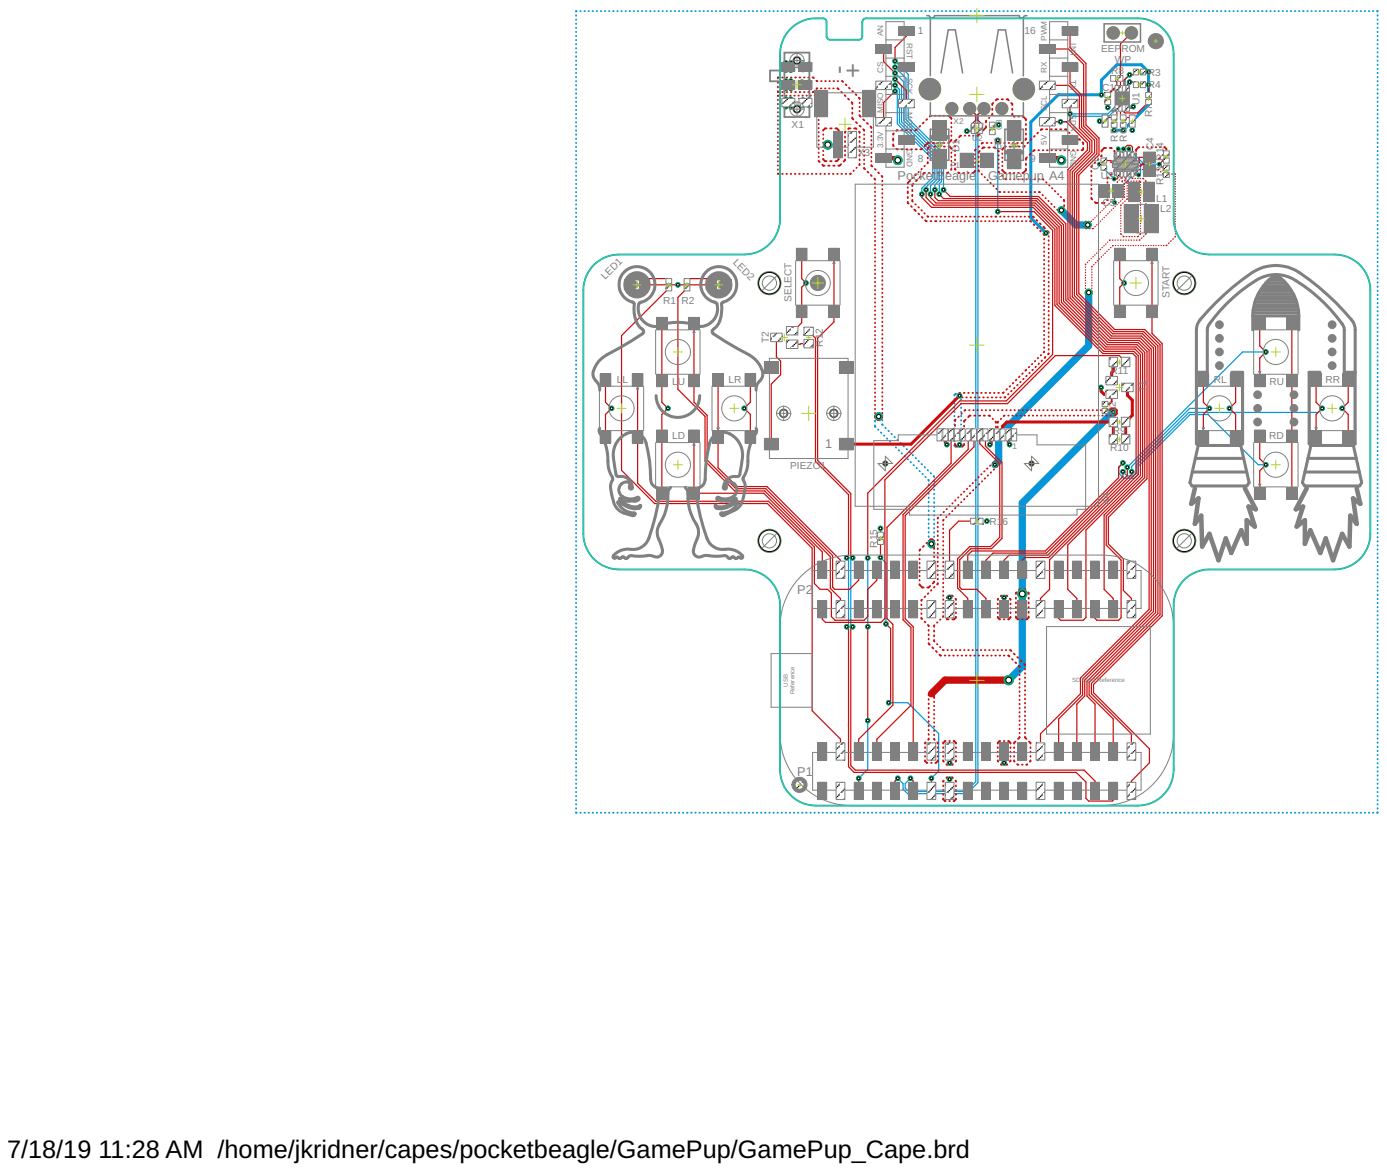
[picture p6: page 1]

SCK MISO MOSI 3.3V GND

SD Card Reference USB Reference

7/18/19 11:28 AM /home/jkridner/capes/pocketbeagle/GamePup/GamePup_Cape.brd
