beagleboard/capes/pocketbeagle/GamePup/GamePup_Cape_sch.pdf

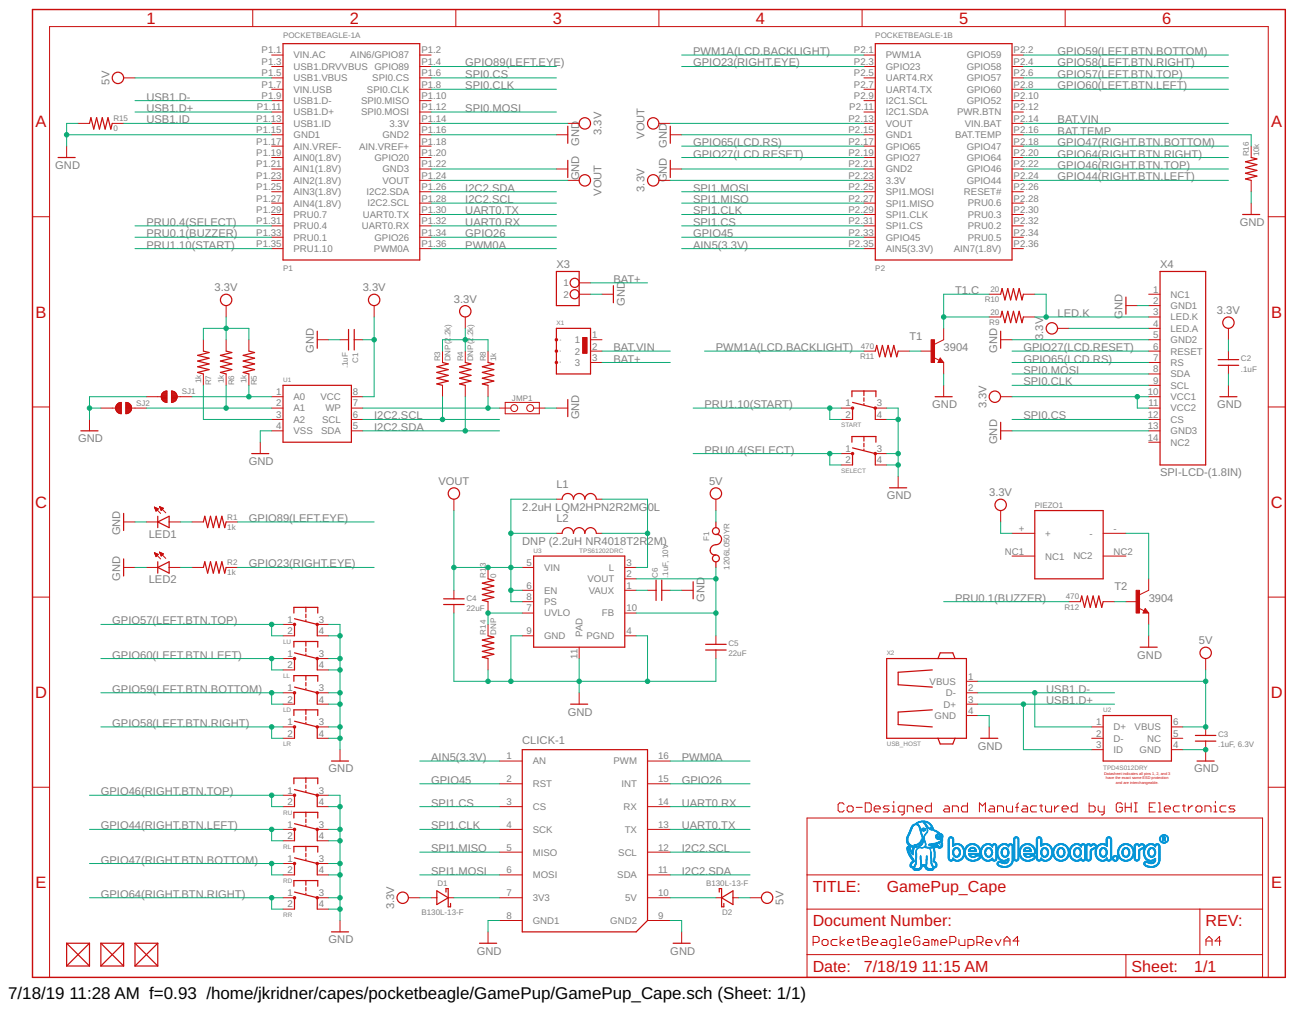
[picture p7: page 1]

VOUT VOUT GND GND

TPD4S012DRY
Datasheet indicates all pins 1, 2, and 3
have the exact same ESD protection
and are interchangeable.

Document Number: | REV:

Date: 7/18/19 11:15 AM | Sheet: 1/1

7/18/19 11:28 AM f=0.93 /home/jkridner/capes/pocketbeagle/GamePup/GamePup_Cape.sch (Sheet: 1/1)
