beagleboard/capes/beaglebone/Comms/Comms_Cape_sch.pdf

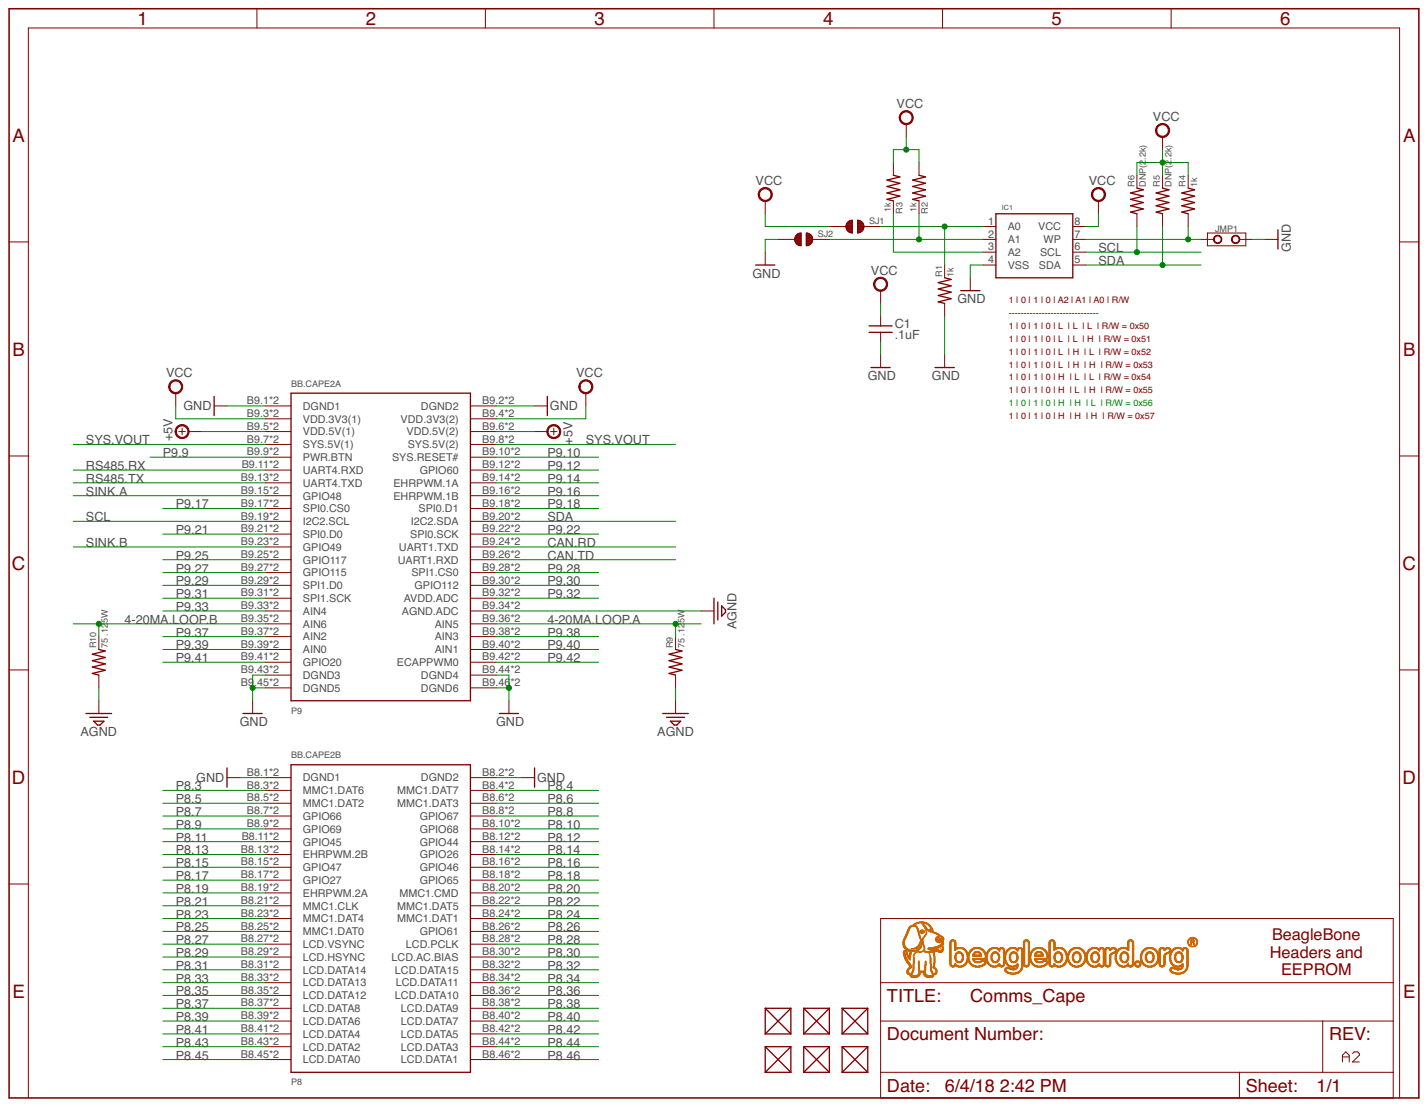
[picture p9: page 1]

GND 1k VCC .1uF 1k 1k1k DNP(2.2k) DNP(2.2k) VCC GNDVCC GND GND GND VCC VCC GND GND GND GND GND +5V VCC +5V GND GND SN65HVD230 .1uF VCC VCC GND GND 74LVC1G57 MAX13487EESA +5V +5V GND GND VCC VCC 120 GND 120 330 1k GND 330 1k GNDPBSS4350Z 50V 3A PBSS4350Z 50V 3A 75 .125W 75 .125W .1uF .1uF VCC GND +5V GND AGND AGND AGND VCC GND P9P8 A0 1 A1 2 A2 3 VSS 4 SDA 5 SCL 6 WP 7 VCC 8 IC1 R4 C1 JMP1 R1 R2 R3 R6 R5 SJ1 SJ2 12X1345678910 IC4TXD 1 VSS 2 VDD 3 RXD 4 VREF 5 CANL 6 CANH 7 RS 8 C2 IN1 IN0 IN2 Y GND VCC IC2 RO 1 RE 2 SHDN 3 DI 4 GND 5 A 6 B 7 VCC 8 IC3 R8 SJ3 SJ4 R7 R12 R11 LED1 R14 R13 LED2 T1T2 R9 R10 C4 C3 DGND1 B9.1*2 DGND2 B9.2*2 VDD.3V3(1) B9.3*2 VDD.3V3(2) B9.4*2 VDD.5V(1) B9.5*2 VDD.5V(2) B9.6*2 SYS.5V(1) B9.7*2 SYS.5V(2) B9.8*2 PWR.BTN B9.9*2 SYS.RESET# B9.10*2 UART4.RXD B9.11*2 GPIO60 B9.12*2 UART4.TXD B9.13*2 EHRPWM.1A B9.14*2 GPIO48 B9.15*2 EHRPWM.1B B9.16*2 SPI0.CS0 B9.17*2 SPI0.D1 B9.18*2 I2C2.SCL B9.19*2 I2C2.SDA B9.20*2 GPIO49 B9.23*2 SPI0.SCK B9.22*2 GPIO117 B9.25*2 UART1.TXD B9.24*2 GPIO115 B9.27*2 UART1.RXD B9.26*2 SPI1.D0 B9.29*2 SPI1.CS0 B9.28*2 SPI1.SCK B9.31*2 GPIO112 B9.30*2 AIN4 B9.33*2 AVDD.ADC B9.32*2 AIN6 B9.35*2 AGND.ADC B9.34*2 AIN2 B9.37*2 AIN5 B9.36*2 AIN0 B9.39*2 AIN3 B9.38*2 GPIO20 B9.41*2 AIN1 B9.40*2 DGND3 B9.43*2 DGND4 B9.44*2 DGND5 B9.45*2 DGND6 B9.46*2 SPI0.D0 B9.21*2 ECAPPWM0 B9.42*2 BB.CAPE2A DGND1 B8.1*2 DGND2 B8.2*2 MMC1.DAT6 B8.3*2 MMC1.DAT7 B8.4*2 MMC1.DAT2 B8.5*2 MMC1.DAT3 B8.6*2 GPIO66 B8.7*2 GPIO67 B8.8*2 GPIO69 B8.9*2 GPIO68 B8.10*2 GPIO45 B8.11*2 GPIO44 B8.12*2 EHRPWM.2B B8.13*2 GPIO26 B8.14*2 GPIO47 B8.15*2 GPIO46 B8.16*2 GPIO27 B8.17*2 GPIO65 B8.18*2 EHRPWM.2A B8.19*2 MMC1.CMD B8.20*2 MMC1.CLK B8.21*2 MMC1.DAT5 B8.22*2 MMC1.DAT4 B8.23*2 MMC1.DAT1 B8.24*2 MMC1.DAT0 B8.25*2 GPIO61 B8.26*2 LCD.VSYNC B8.27*2 LCD.PCLK B8.28*2 LCD.HSYNC B8.29*2 LCD.AC.BIAS B8.30*2 LCD.DATA14 B8.31*2 LCD.DATA15 B8.32*2 LCD.DATA13 B8.33*2 LCD.DATA11 B8.34*2 LCD.DATA12 B8.35*2 LCD.DATA10 B8.36*2 LCD.DATA8 B8.37*2 LCD.DATA9 B8.38*2 LCD.DATA6 B8.39*2 LCD.DATA7 B8.40*2 LCD.DATA4 B8.41*2 LCD.DATA5 B8.42*2 LCD.DATA2 B8.43*2 LCD.DATA3 B8.44*2 LCD.DATA0 B8.45*2 LCD.DATA1 B8.46*2 BB.CAPE2B SCL SCL SDA SDA SYS.VOUT SYS.VOUT CAN.RD CAN.RD CAN.TD CAN.TD RS485.RX RS485.RX RS485.TX RS485.TX CAN.H CAN.H CAN.L CAN.L 4-20MA.LOOP.B 4-20MA.LOOP.B 4-20MA.LOOP.A 4-20MA.LOOP.A RS485.B RS485.B RS485.A RS485.A SINK.A-TB SINK.A-TB SINK.B-TB SINK.B-TB SINK.B SINK.B SINK.A SINK.A P9.9P9.17 P9.21 P9.25 P9.27 P9.29 P9.31 P9.33 P9.37 P9.39 P9.41 P9.14 P9.10 P9.12 P9.16 P9.18 P9.22 P9.28 P9.30 P9.32 P9.38 P9.40 P9.42 P8.3 P8.5 P8.7 P8.9 P8.11 P8.13 P8.15 P8.17 P8.19 P8.21 P8.23 P8.25 P8.4 P8.6 P8.8 P8.10 P8.12 P8.14 P8.16 P8.18 P8.20 P8.22 P8.24 P8.26 P8.27 P8.29 P8.31 P8.33 P8.35 P8.37 P8.39 P8.41 P8.43 P8.45 P8.28 P8.30 P8.32 P8.34 P8.36 P8.38 P8.40 P8.42 P8.44 P8.46 1 | 0 | 1 | 0 | A2 | A1 | A0 | R/W 1 | 0 | 1 | 0 | L | L | L | R/W = 0x50 1 | 0 | 1 | 0 | L | L | H | R/W = 0x51 1 | 0 | 1 | 0 | L | H | L | R/W = 0x52 1 | 0 | 1 | 0 | L | H | H | R/W = 0x53 1 | 0 | 1 | 0 | H | L | L | R/W = 0x54 1 | 0 | 1 | 0 | H | L | H | R/W = 0x55 1 | 0 | 1 | 0 | H | H | H | R/W = 0x57 ------------------------------ BeagleBone Headers and EEPROM CAN and RS485 ICs and Sink transistors ABCDE ABCDE 1 2 3 4 5 6 Date: 6/4/18 2:42 PM Sheet: 1/1REV: TITLE: Document Number: Comms_Cape ABCDE ABCDE 1 2 3 4 5 6 Date: 6/4/18 2:42 PM Sheet: 1/1REV: TITLE: Document Number: Comms_Cape 1 | 0 | 1 | 0 | H | H | L | R/W = 0x56

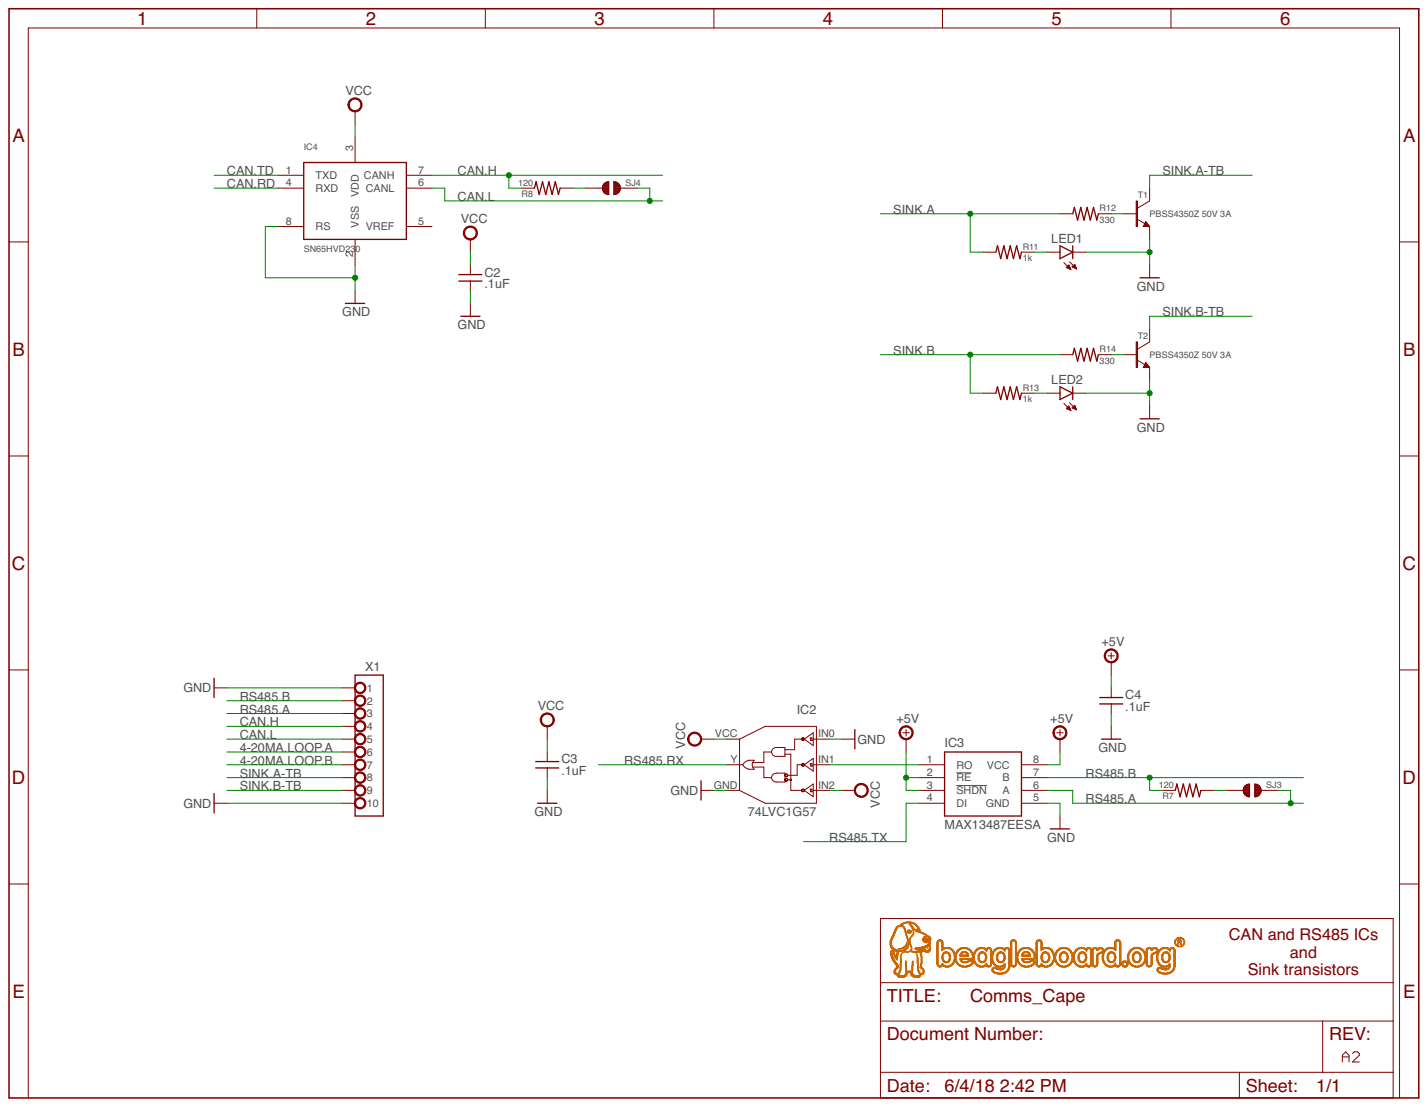
[picture p10: page 2]

Document Number: | REV:

Date: 6/4/18 2:42 PM | Sheet: 1/1
