beagleboard/capes/beaglebone/Load/Load_Cape_sch.pdf

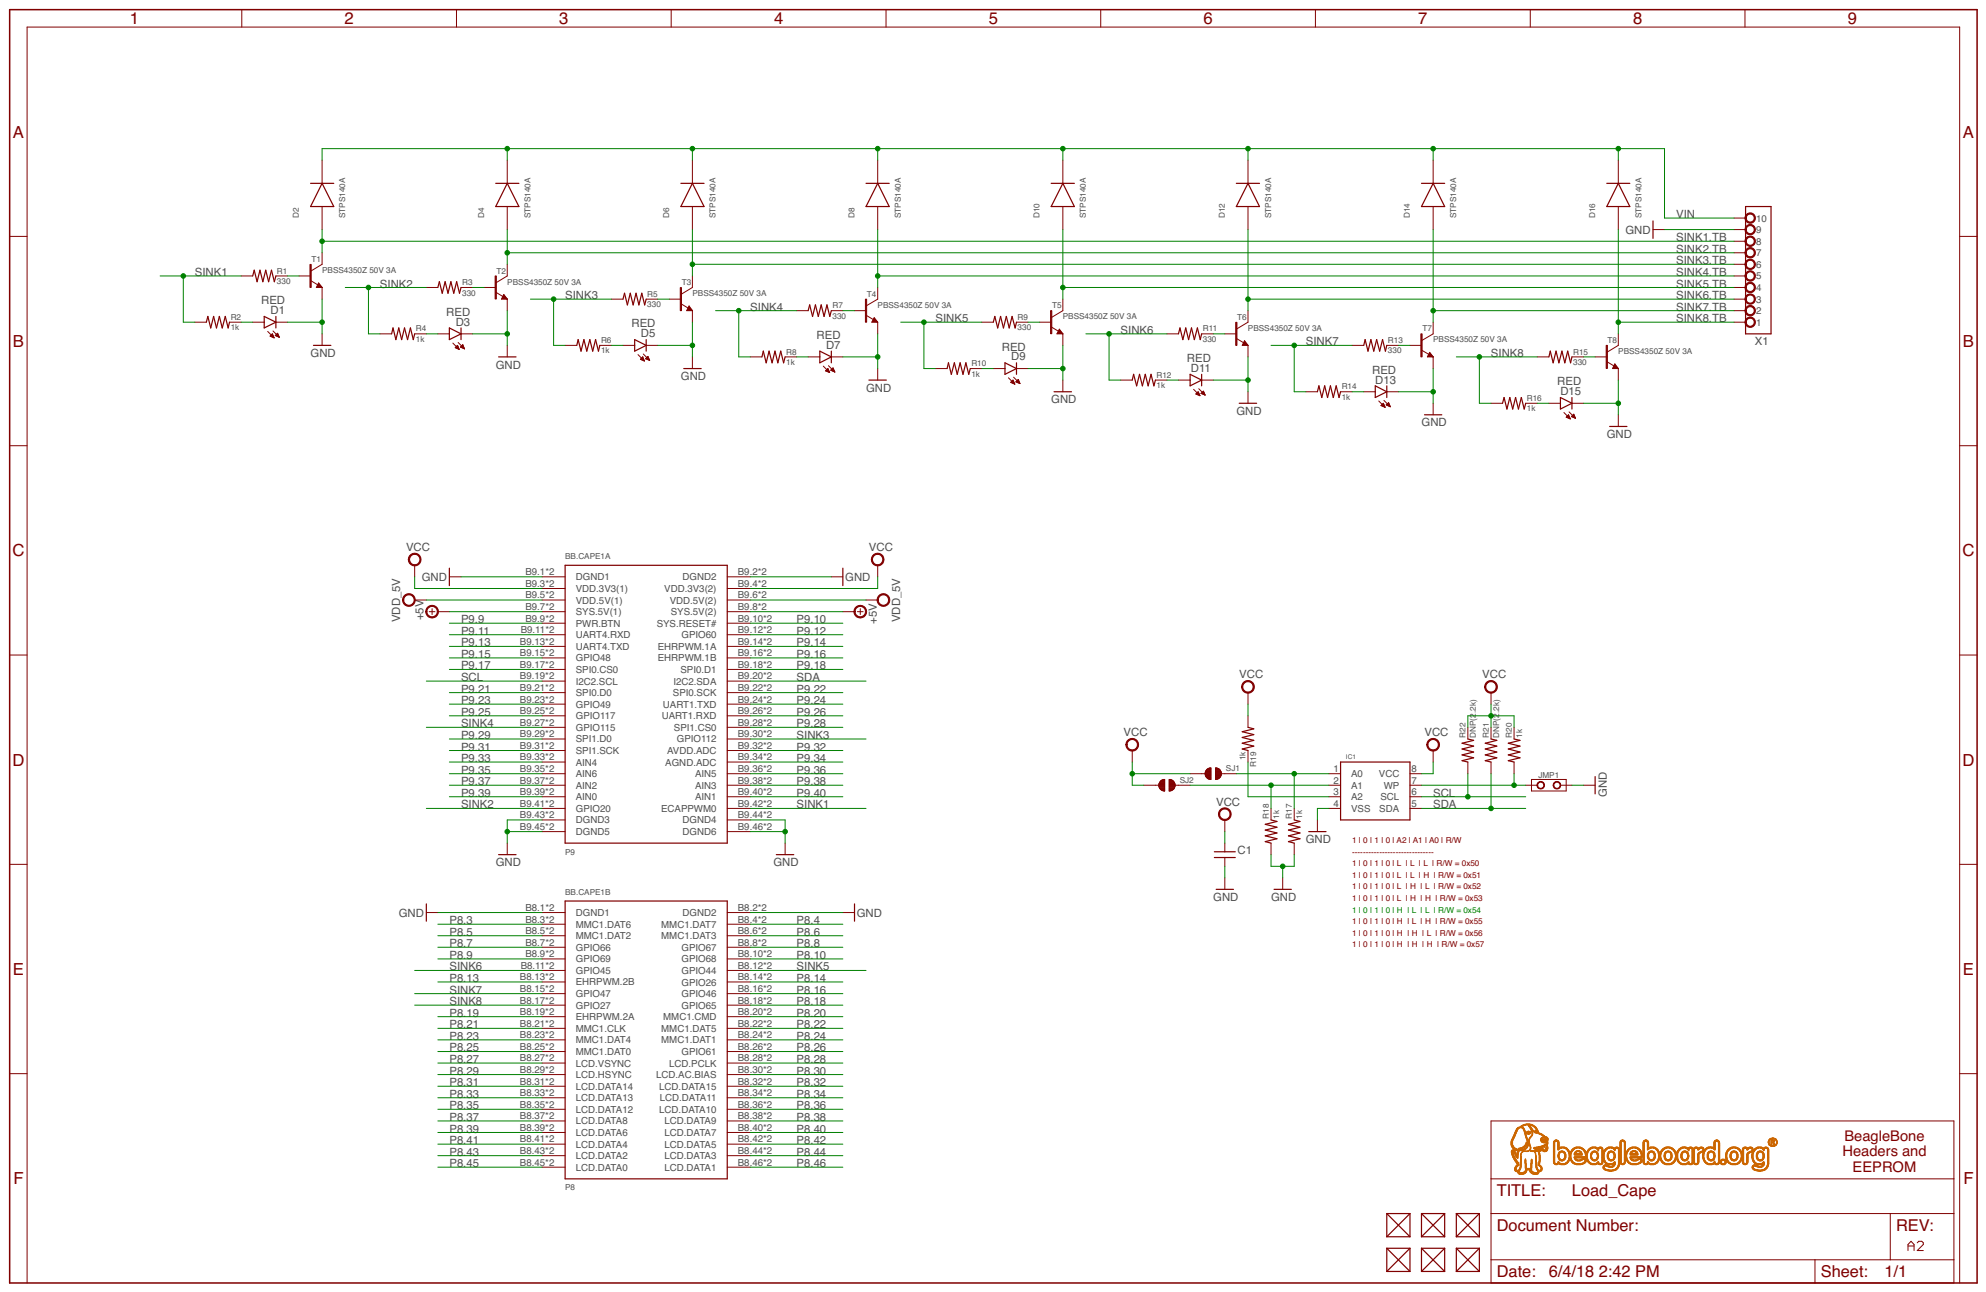
[picture p11: page 1]

BB.CAPE1A | SINK3.TB

SINK4.TB
SINK5.TB
SINK6.TB
SINK7.TB
SINK8.TB

PBSS4350Z 50V 3A GND GND GND GND GND GND GND

BeagleBone Headers and EEPROM

REV: TITLE: Document Number: Load_Cape
