beagleboard/capes/beaglebone/Motor/Motor_Cape_sch.pdf

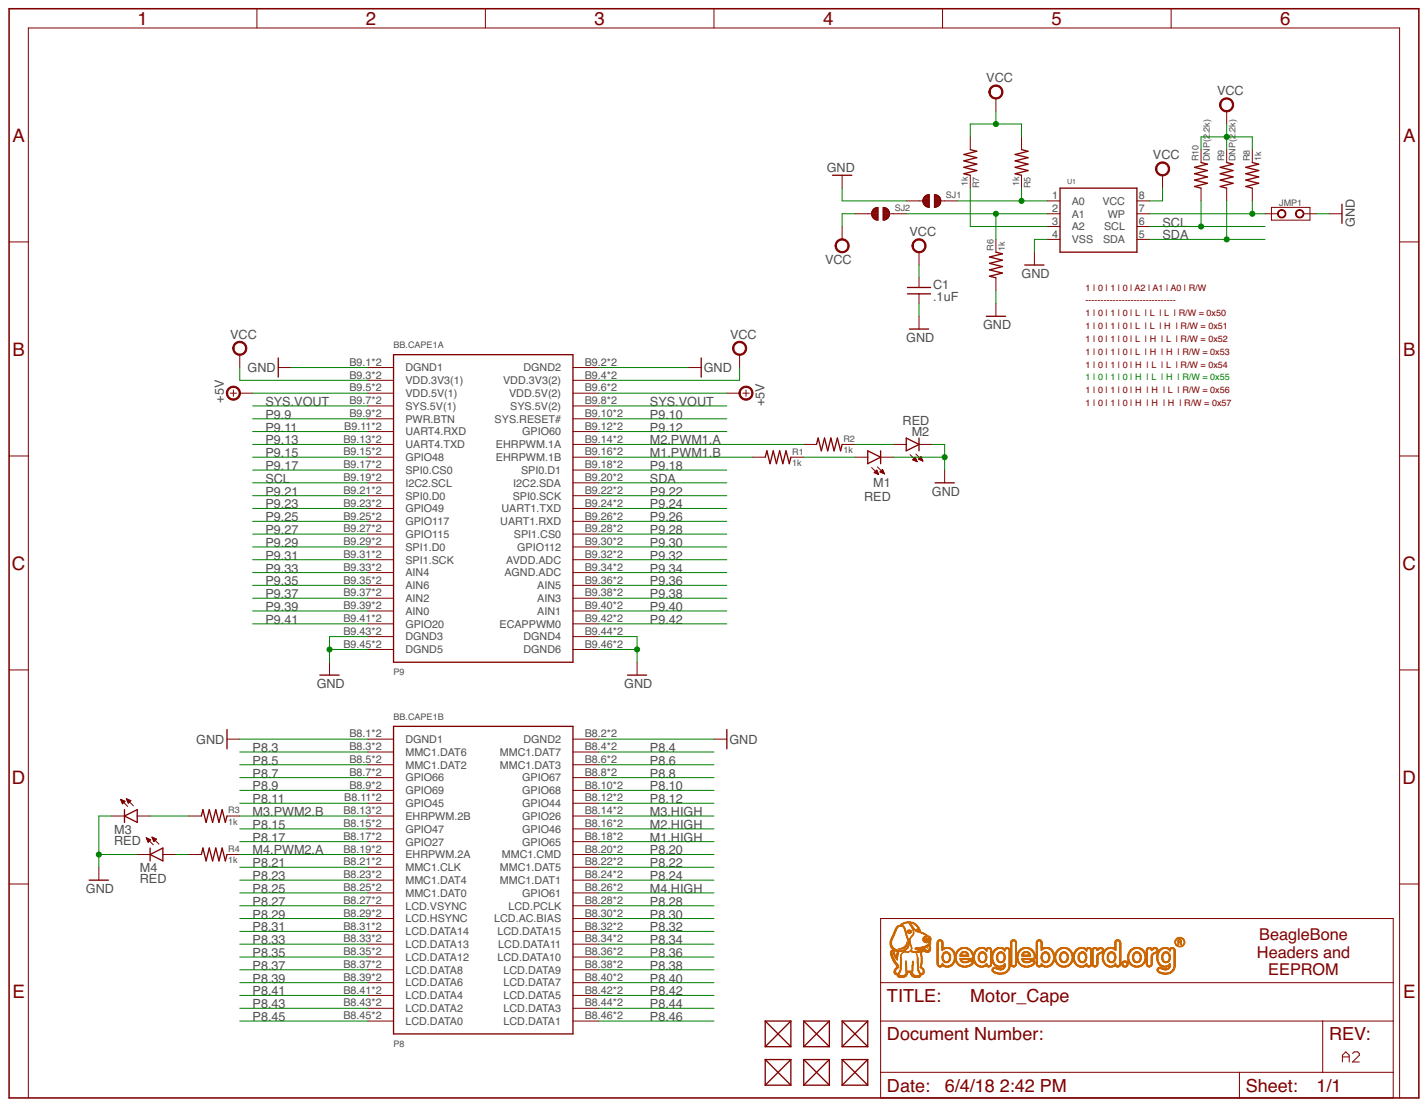
[picture p12: page 1]

GND 1k VCC .1uF 1k 1k 1k DNP(2.2k) DNP(2.2k) VCC GND VCC GND GND VCC VCC GND GND GND GND GND +5V VCC VIN +5V GND B260A-13-F 60V 2A GND GND B260A-13-F 60V 2A B260A-13-F 60V 2A B260A-13-F 60V 2A B260A-13-F 60V 2A B260A-13-F 60V 2A B260A-13-F 60V 2A B260A-13-F 60V 2A B260A-13-F 60V 2A B260A-13-F 60V 2A B260A-13-F 60V 2A B260A-13-F 60V 2A B260A-13-F 60V 2A B260A-13-F 60V 2A B260A-13-F 60V 2A B260A-13-F 60V 2A VIN VIN GND GND +5V VIN VIN GND GND GND GND GND GND GND GND +5V VCC GND GND GND GND VCC GND GND GND GND VCC VCC 74LVC1G57 74LVC1G57 74LVC1G57 74LVC1G57 .1uF .1uF .1uF .1uF .1uF 50V .1uF 50V GND 1k GND RED RED REDRED 1k 1k1k GND GND GND GND VCC P9P8 .1uF .1uF GNDGND A0 1 A1 2 A2 3 VSS 4 SDA 5 SCL 6 WP 7 VCC 8 U1 R8 C1 JMP1 R5 R6 R7 R10 R9 SJ1 SJ2 12X1345678910 D1 GND1 1 SENSE.A 2 NC1 3 OUT1 4 OUT2 5 VS 6 INPUT1 7 ENABLE.A 8 INPUT2 9 GND2 10 GND3 11 VSS 12 INPUT3 13 ENABLE.B 14 INPUT4 15 OUT3 16 OUT4 17 NC2 18 SENSE.B 19 GND4 20 U2 THERMAL.PAD GND1 1 SENSE.A 2 NC1 3 OUT1 4 OUT2 5 VS 6 INPUT1 7 ENABLE.A 8 INPUT2 9 GND2 10 GND3 11 VSS 12 INPUT3 13 ENABLE.B 14 INPUT4 15 OUT3 16 OUT4 17 NC2 18 SENSE.B 19 GND4 20 U3 THERMAL.PAD D2 D3 D4 D5 D6 D7 D8 D9 D10 D11 D12 D13 D14 D15 D16 IN1 IN0 IN2 YGND VCC U4 IN1 IN0 IN2 YGND VCC U5 IN1 IN0 IN2 Y GND VCC U6 IN1 IN0 IN2 Y GND VCC U7 C2 C3 C4 C5 C6 C7 R1 M1 M2 M3 M4 R2 R3 R4 DGND1 B9.1*2 DGND2 B9.2*2 VDD.3V3(1) B9.3*2 VDD.3V3(2) B9.4*2 VDD.5V(1) B9.5*2 VDD.5V(2) B9.6*2 SYS.5V(1) B9.7*2 SYS.5V(2) B9.8*2 PWR.BTN B9.9*2 SYS.RESET# B9.10*2 UART4.RXD B9.11*2 GPIO60 B9.12*2 UART4.TXD B9.13*2 EHRPWM.1A B9.14*2 GPIO48 B9.15*2 EHRPWM.1B B9.16*2 SPI0.CS0 B9.17*2 SPI0.D1 B9.18*2 I2C2.SCL B9.19*2 I2C2.SDA B9.20*2 GPIO49 B9.23*2 SPI0.SCK B9.22*2 GPIO117 B9.25*2 UART1.TXD B9.24*2 GPIO115 B9.27*2 UART1.RXD B9.26*2 SPI1.D0 B9.29*2 SPI1.CS0 B9.28*2 SPI1.SCK B9.31*2 GPIO112 B9.30*2 AIN4 B9.33*2 AVDD.ADC B9.32*2 AIN6 B9.35*2 AGND.ADC B9.34*2 AIN2 B9.37*2 AIN5 B9.36*2 AIN0 B9.39*2 AIN3 B9.38*2 GPIO20 B9.41*2 AIN1 B9.40*2 DGND3 B9.43*2 DGND4 B9.44*2 DGND5 B9.45*2 DGND6 B9.46*2 SPI0.D0 B9.21*2 ECAPPWM0 B9.42*2 BB.CAPE1A DGND1 B8.1*2 DGND2 B8.2*2 MMC1.DAT6 B8.3*2 MMC1.DAT7 B8.4*2 MMC1.DAT2 B8.5*2 MMC1.DAT3 B8.6*2 GPIO66 B8.7*2 GPIO67 B8.8*2 GPIO69 B8.9*2 GPIO68 B8.10*2 GPIO45 B8.11*2 GPIO44 B8.12*2 EHRPWM.2B B8.13*2 GPIO26 B8.14*2 GPIO47 B8.15*2 GPIO46 B8.16*2 GPIO27 B8.17*2 GPIO65 B8.18*2 EHRPWM.2A B8.19*2 MMC1.CMD B8.20*2 MMC1.CLK B8.21*2 MMC1.DAT5 B8.22*2 MMC1.DAT4 B8.23*2 MMC1.DAT1 B8.24*2 MMC1.DAT0 B8.25*2 GPIO61 B8.26*2 LCD.VSYNC B8.27*2 LCD.PCLK B8.28*2 LCD.HSYNC B8.29*2 LCD.AC.BIAS B8.30*2 LCD.DATA14 B8.31*2 LCD.DATA15 B8.32*2 LCD.DATA13 B8.33*2 LCD.DATA11 B8.34*2 LCD.DATA12 B8.35*2 LCD.DATA10 B8.36*2 LCD.DATA8 B8.37*2 LCD.DATA9 B8.38*2 LCD.DATA6 B8.39*2 LCD.DATA7 B8.40*2 LCD.DATA4 B8.41*2 LCD.DATA5 B8.42*2 LCD.DATA2 B8.43*2 LCD.DATA3 B8.44*2 LCD.DATA0 B8.45*2 LCD.DATA1 B8.46*2 BB.CAPE1B C8 C9 SCL SCL SDA SDA SYS.VOUT SYS.VOUT M1- M1- M1- M1+ M1+ M1+ M2-M2- M2- M2+ M2+ M2+ M3- M3- M3- M3+ M3+ M3+ M4- M4- M4- M4+ M4+ M4+ M2.PWM1.A M2.PWM1.A M1.PWM1.B M1.PWM1.B M3.PWM2.B M3.PWM2.B M4.PWM2.A M4.PWM2.A M1.HIGH M1.HIGH M1.HIGH M1.LOW M4.LOW M4.HIGH M4.HIGH M4.HIGH M3.LOW M3.HIGH M3.HIGH M3.HIGH M2.LOW M2.HIGH M2.HIGH M2.HIGH P8.10 P8.11 P8.12 P8.3 P8.5 P8.7 P8.9 P8.15 P8.17 P8.21 P8.23 P8.25 P8.4 P8.6 P8.8 P8.20 P8.22 P8.24 P8.27 P8.29 P8.31 P8.33 P8.35 P8.37 P8.39 P8.41 P8.43 P8.45 P8.28 P8.30 P8.32 P8.34 P8.36 P8.38 P8.40 P8.42 P8.44 P8.46 P9.27 P9.41 P9.9 P9.11 P9.13 P9.15 P9.17 P9.21 P9.23 P9.29 P9.31 P9.33 P9.35 P9.37 P9.39 P9.25 P9.30 P9.42 P9.10 P9.12 P9.18 P9.22 P9.24 P9.26 P9.28 P9.32 P9.34 P9.36 P9.38 P9.40 1 | 0 | 1 | 0 | A2 | A1 | A0 | R/W 1 | 0 | 1 | 0 | L | L | L | R/W = 0x50 1 | 0 | 1 | 0 | L | L | H | R/W = 0x51 1 | 0 | 1 | 0 | L | H | L | R/W = 0x52 1 | 0 | 1 | 0 | L | H | H | R/W = 0x53 1 | 0 | 1 | 0 | H | L | L | R/W = 0x54 1 | 0 | 1 | 0 | H | H | L | R/W = 0x56 1 | 0 | 1 | 0 | H | H | H | R/W = 0x57 ------------------------------ BeagleBone Headers and EEPROM Motor ICs and Header Power Supply Logic Supply Power Supply Logic Supply ABCDE ABCDE 1 2 3 4 5 6 Date: 6/4/18 2:42 PM Sheet: 1/1REV: TITLE: Document Number: Motor_Cape ABCDE ABCDE 1 2 3 4 5 6 Date: 6/4/18 2:42 PM Sheet: 1/1REV: TITLE: Document Number: Motor_Cape 1 | 0 | 1 | 0 | H | L | H | R/W = 0x55

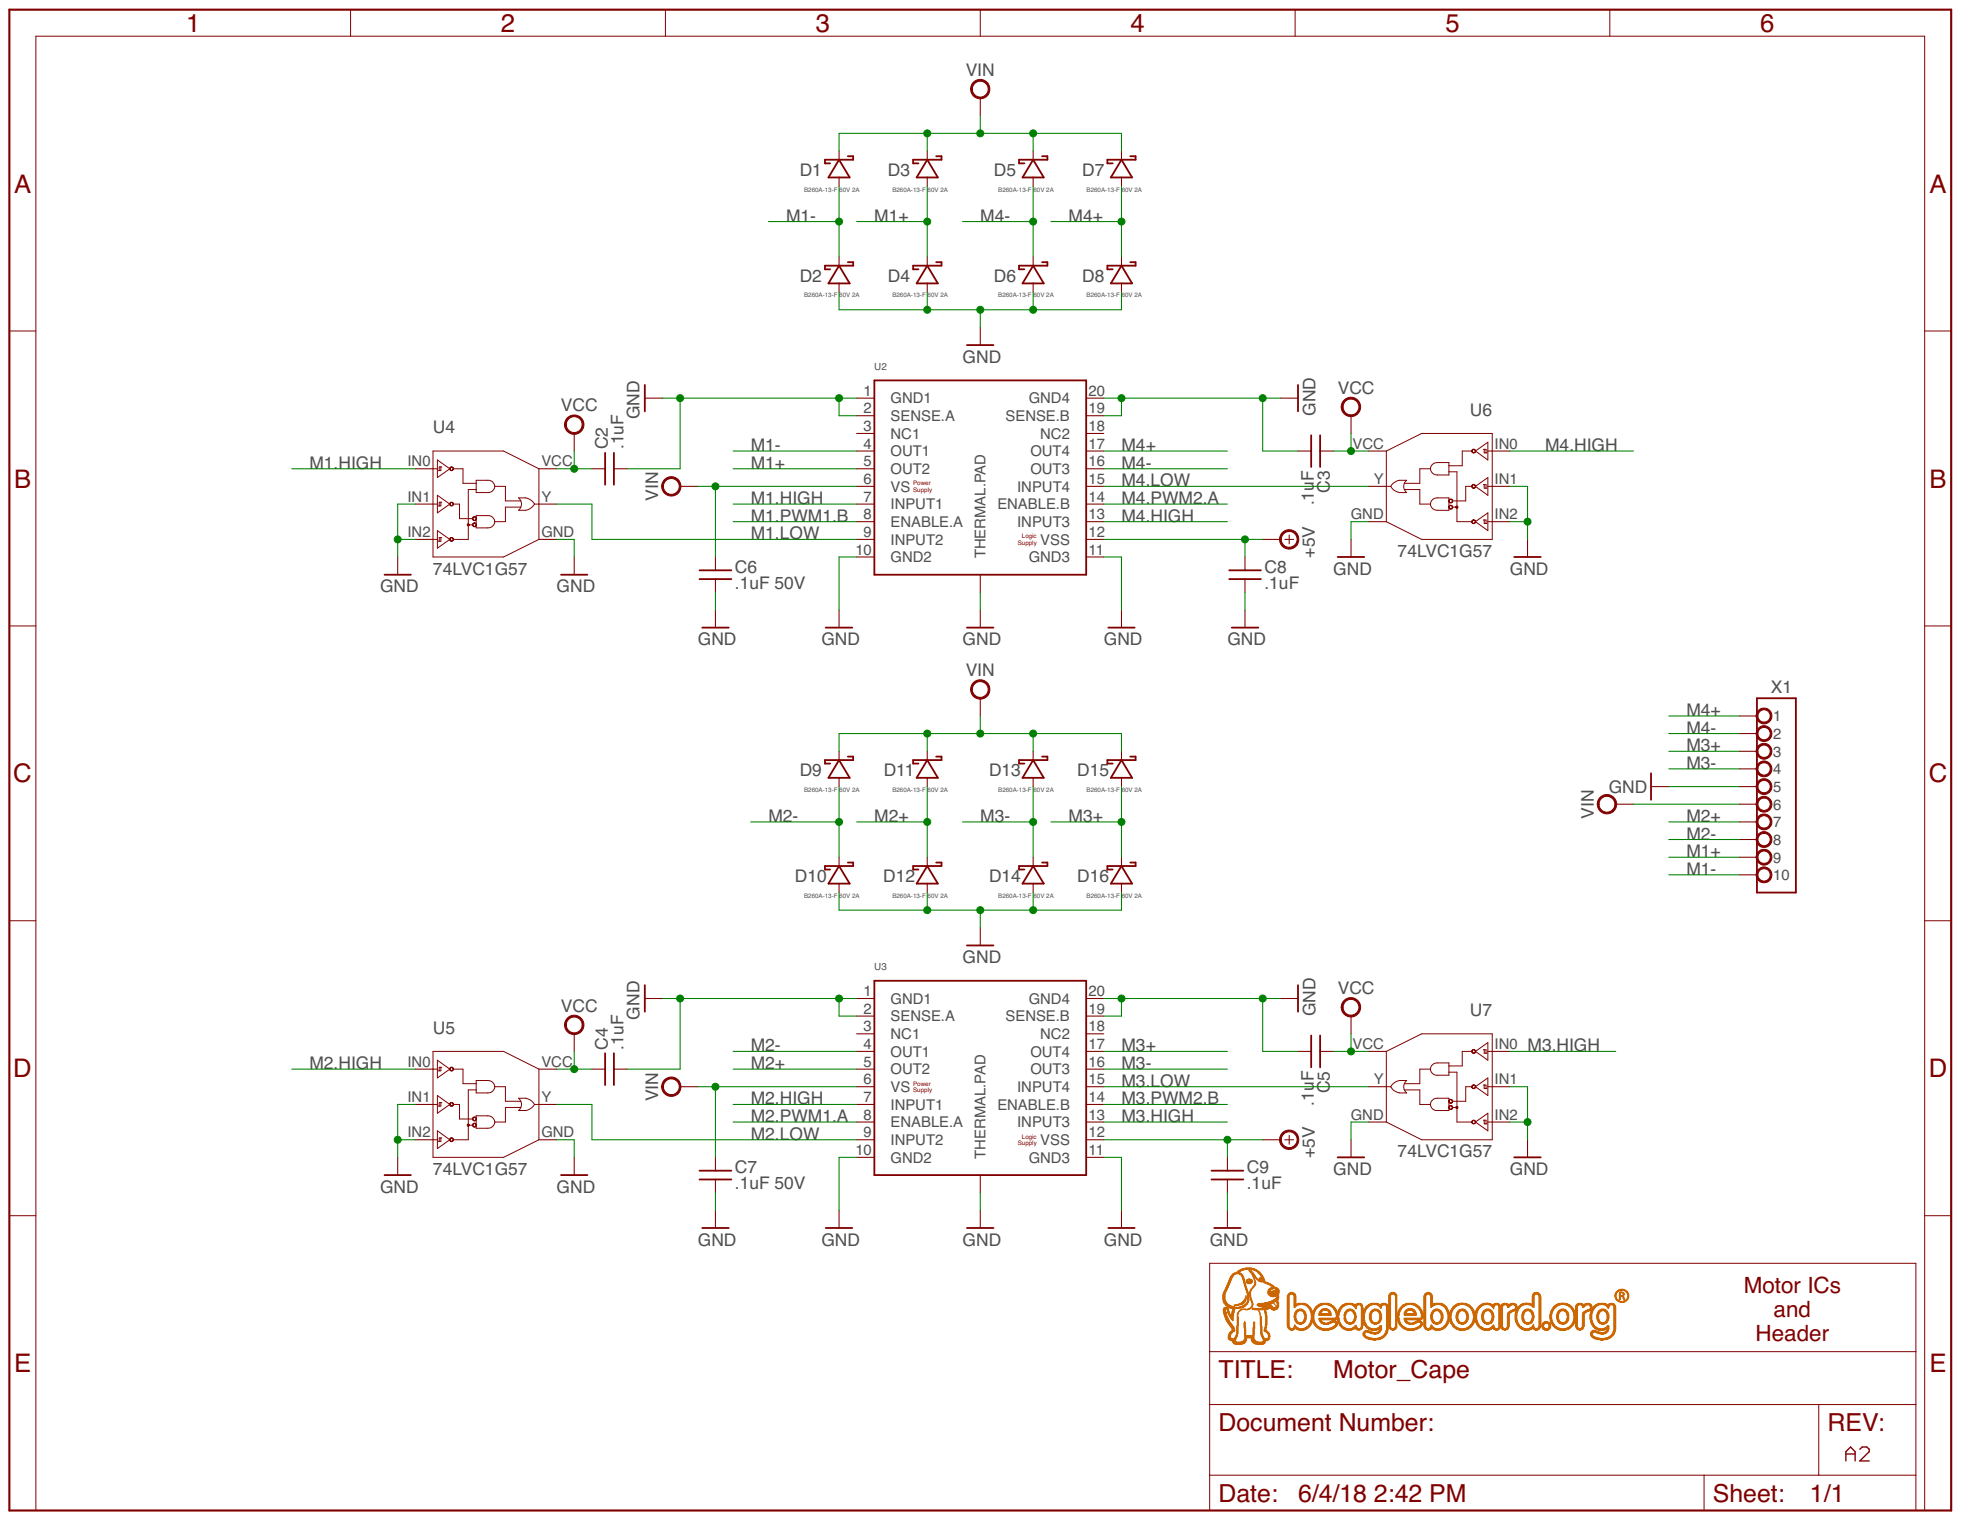
[picture p13: page 2]

VIN VIN GND GND

Document Number: | REV:

Date: 6/4/18 2:42 PM | Sheet: 1/1
