beagleboard/capes/beaglebone/Relay/Relay_Cape_sch.pdf

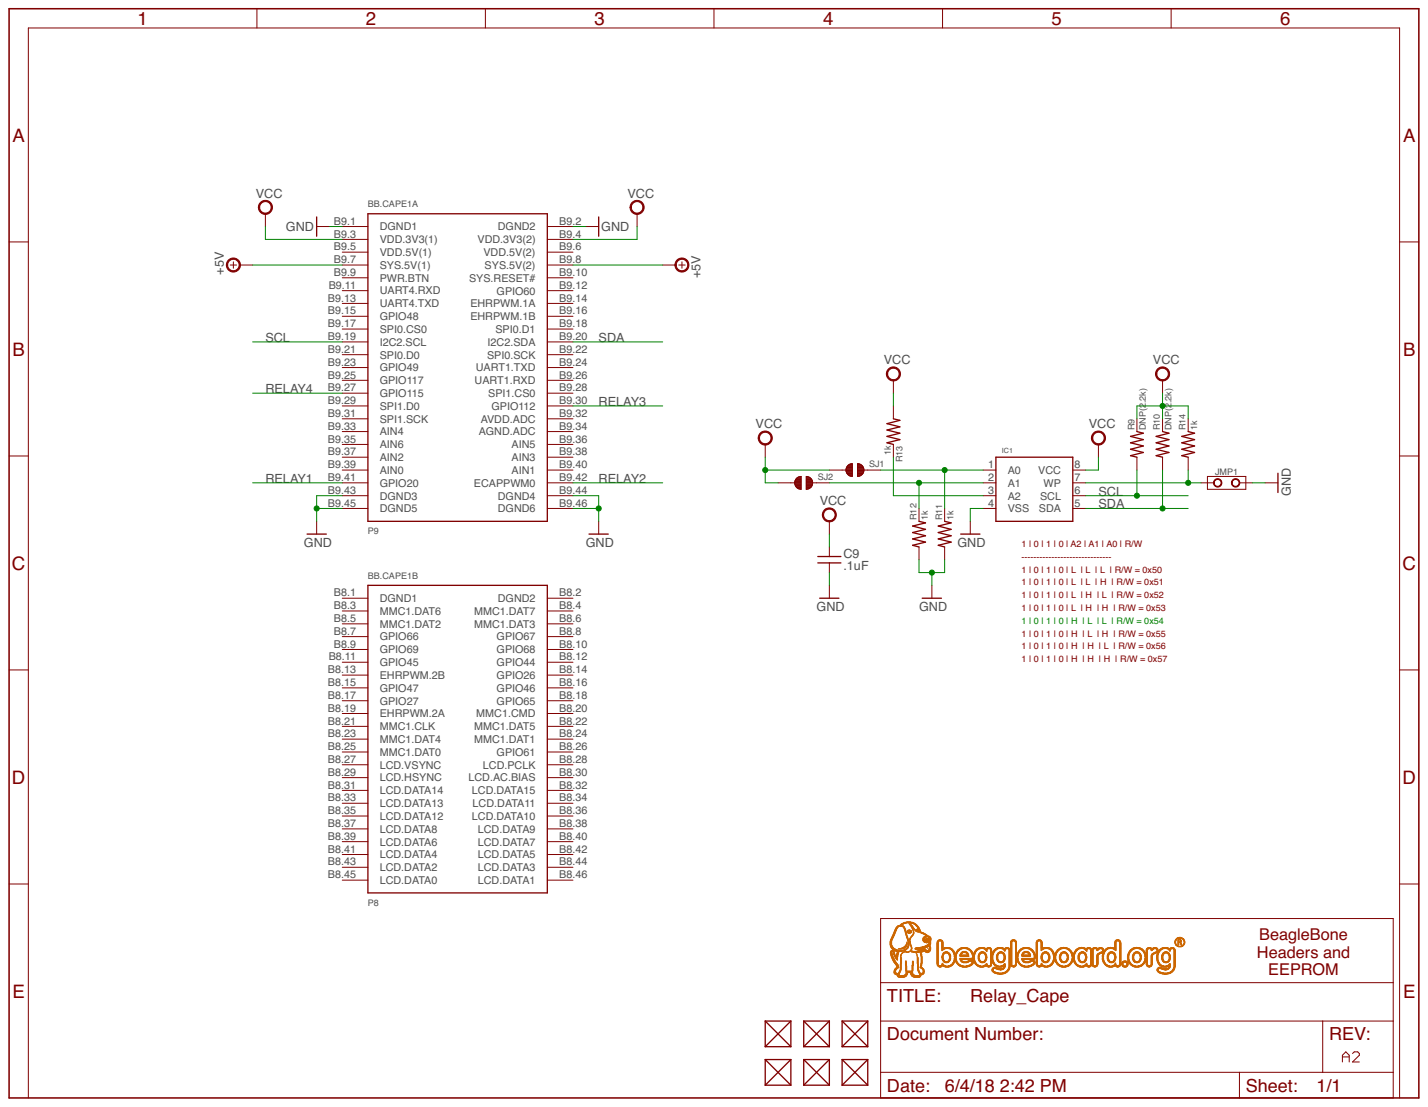
[picture p14: page 1]

GND P9P8 1k VCC .1uF 1k1k 1k DNP(2.2k) DNP(2.2k) VCC GND VCC GND GND VCC VCC GND GND GND +5V +5V RELAY_SINGLE_POLE_DOUBLE_THROW 10uF .1uF +5V B260 3904GREEN 1k GND 1k GND RELAY_SINGLE_POLE_DOUBLE_THROW 10uF .1uF +5V B260 3904GREEN 1k GND 1k GND RELAY_SINGLE_POLE_DOUBLE_THROW 10uF .1uF +5V B260 3904GREEN 1k GND 1k GND RELAY_SINGLE_POLE_DOUBLE_THROW 10uF .1uF +5V B260 3904GREEN 1k GND 1k GND VCC VCC GND DGND1 B9.1 DGND2 B9.2 VDD.3V3(1) B9.3 VDD.3V3(2) B9.4 VDD.5V(1) B9.5 VDD.5V(2) B9.6 SYS.5V(1) B9.7 SYS.5V(2) B9.8 PWR.BTN B9.9 SYS.RESET# B9.10 UART4.RXD B9.11 GPIO60 B9.12 UART4.TXD B9.13 EHRPWM.1A B9.14 GPIO48 B9.15 EHRPWM.1B B9.16 SPI0.CS0 B9.17 SPI0.D1 B9.18 I2C2.SCL B9.19 I2C2.SDA B9.20 GPIO49 B9.23 SPI0.SCK B9.22 GPIO117 B9.25 UART1.TXD B9.24 GPIO115 B9.27 UART1.RXD B9.26 SPI1.D0 B9.29 SPI1.CS0 B9.28 SPI1.SCK B9.31 GPIO112 B9.30 AIN4 B9.33 AVDD.ADC B9.32 AIN6 B9.35 AGND.ADC B9.34 AIN2 B9.37 AIN5 B9.36 AIN0 B9.39 AIN3 B9.38 GPIO20 B9.41 AIN1 B9.40 DGND3 B9.43 DGND4 B9.44 DGND5 B9.45 DGND6 B9.46 SPI0.D0 B9.21 ECAPPWM0 B9.42 BB.CAPE1A DGND1 B8.1 DGND2 B8.2 MMC1.DAT6 B8.3 MMC1.DAT7 B8.4 MMC1.DAT2 B8.5 MMC1.DAT3 B8.6 GPIO66 B8.7 GPIO67 B8.8 GPIO69 B8.9 GPIO68 B8.10 GPIO45 B8.11 GPIO44 B8.12 EHRPWM.2B B8.13 GPIO26 B8.14 GPIO47 B8.15 GPIO46 B8.16 GPIO27 B8.17 GPIO65 B8.18 EHRPWM.2A B8.19 MMC1.CMD B8.20 MMC1.CLK B8.21 MMC1.DAT5 B8.22 MMC1.DAT4 B8.23 MMC1.DAT1 B8.24 MMC1.DAT0 B8.25 GPIO61 B8.26 LCD.VSYNC B8.27 LCD.PCLK B8.28 LCD.HSYNC B8.29 LCD.AC.BIAS B8.30 LCD.DATA14 B8.31 LCD.DATA15 B8.32 LCD.DATA13 B8.33 LCD.DATA11 B8.34 LCD.DATA12 B8.35 LCD.DATA10 B8.36 LCD.DATA8 B8.37 LCD.DATA9 B8.38 LCD.DATA6 B8.39 LCD.DATA7 B8.40 LCD.DATA4 B8.41 LCD.DATA5 B8.42 LCD.DATA2 B8.43 LCD.DATA3 B8.44 LCD.DATA0 B8.45 LCD.DATA1 B8.46 BB.CAPE1B A0 1 A1 2 A2 3 VSS 4 SDA 5 SCL 6 WP 7 VCC 8 IC1 R14 C9 JMP1 R11 R12 R13 R9 R10 SJ1 SJ2 COM NONC V+V- X3 C5 C6 D3 T3 LED3 R6 R5 123 X7 COM NONC V+V- X2 C3 C4 D2 T2 LED2 R4 R3 123 X6 COM NONC V+V- X4 C7 C8 D4 T4 LED4 R8 R7 123 X8 COM NONC V+V- X1 C1 C2 D1 T1 LED1 R2 R1 123 X5 SCL SCL SDA SDA RELAY3.NC RELAY3.NC RELAY3.NO RELAY3.NO RELAY3.COM.GND RELAY3.COM.GND RELAY4.NO RELAY4.NO RELAY4.COM.GND RELAY4.COM.GND RELAY4.NC RELAY4.NC RELAY2.COM.GND RELAY2.COM.GND RELAY2.NO RELAY2.NORELAY2.NC RELAY2.NC RELAY1.COM.GND RELAY1.COM.GND RELAY1.NO RELAY1.NO RELAY1.NC RELAY1.NC RELAY4 RELAY4 RELAY3 RELAY3 RELAY2 RELAY2 RELAY1 RELAY1 1 | 0 | 1 | 0 | A2 | A1 | A0 | R/W 1 | 0 | 1 | 0 | L | L | L | R/W = 0x50 1 | 0 | 1 | 0 | L | L | H | R/W = 0x51 1 | 0 | 1 | 0 | L | H | L | R/W = 0x52 1 | 0 | 1 | 0 | L | H | H | R/W = 0x53 1 | 0 | 1 | 0 | H | L | H | R/W = 0x55 1 | 0 | 1 | 0 | H | H | L | R/W = 0x56 1 | 0 | 1 | 0 | H | H | H | R/W = 0x57 ------------------------------ BeagleBone Headers and EEPROM Relays and Header ABCDE ABCDE 1 2 3 4 5 6 Date: 6/4/18 2:42 PM Sheet: 1/1REV: TITLE: Document Number: Relay_Cape ABCDE ABCDE 1 2 3 4 5 6 Date: 6/4/18 2:42 PM Sheet: 1/1REV: TITLE: Document Number: Relay_Cape 1 | 0 | 1 | 0 | H | L | L | R/W = 0x54

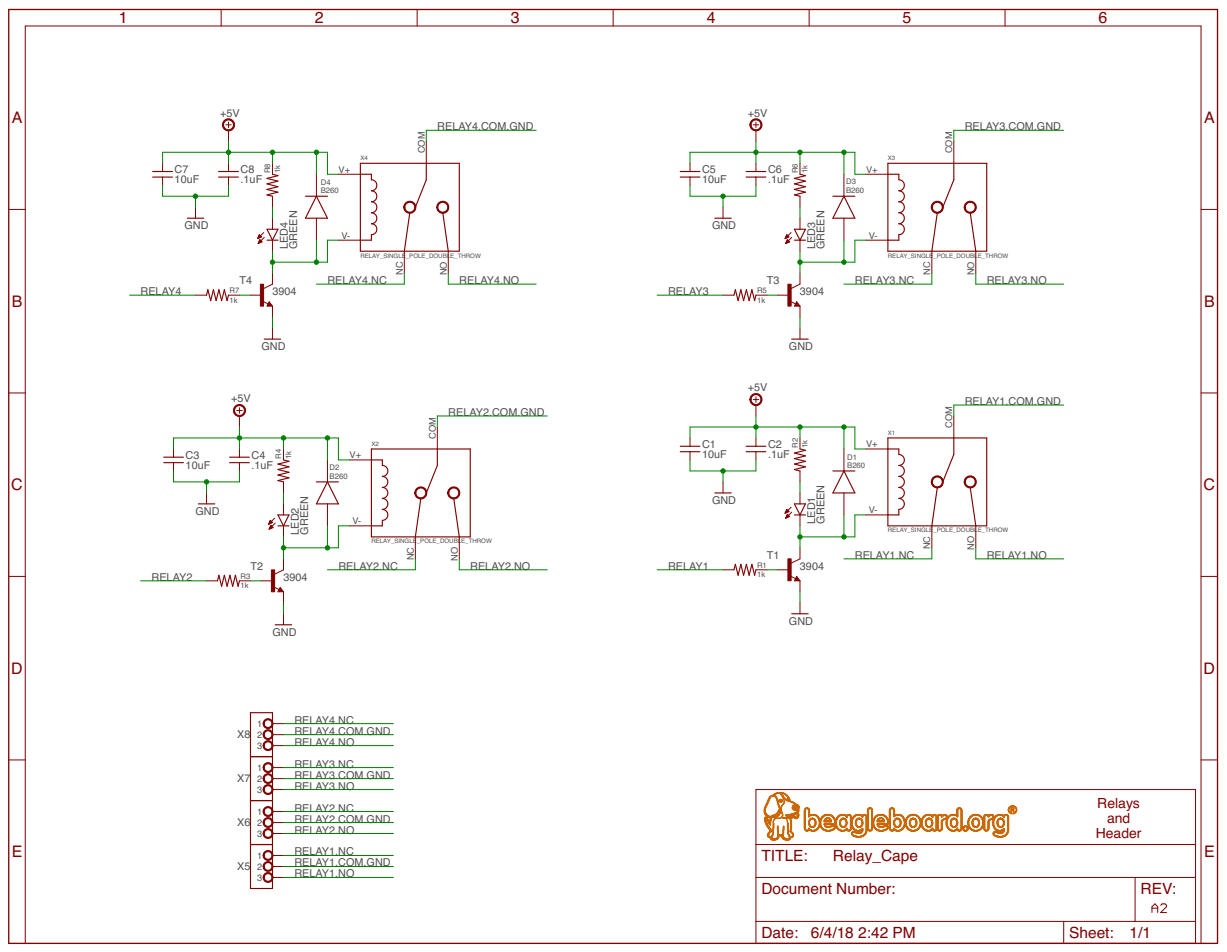
[picture p15: page 2]

Document Number: | REV:

Date: 6/4/18 2:42 PM | Sheet: 1/1
