beagleboard/capes/pocketbeagle/TechLab/TechLab_Cape_brd.pdf

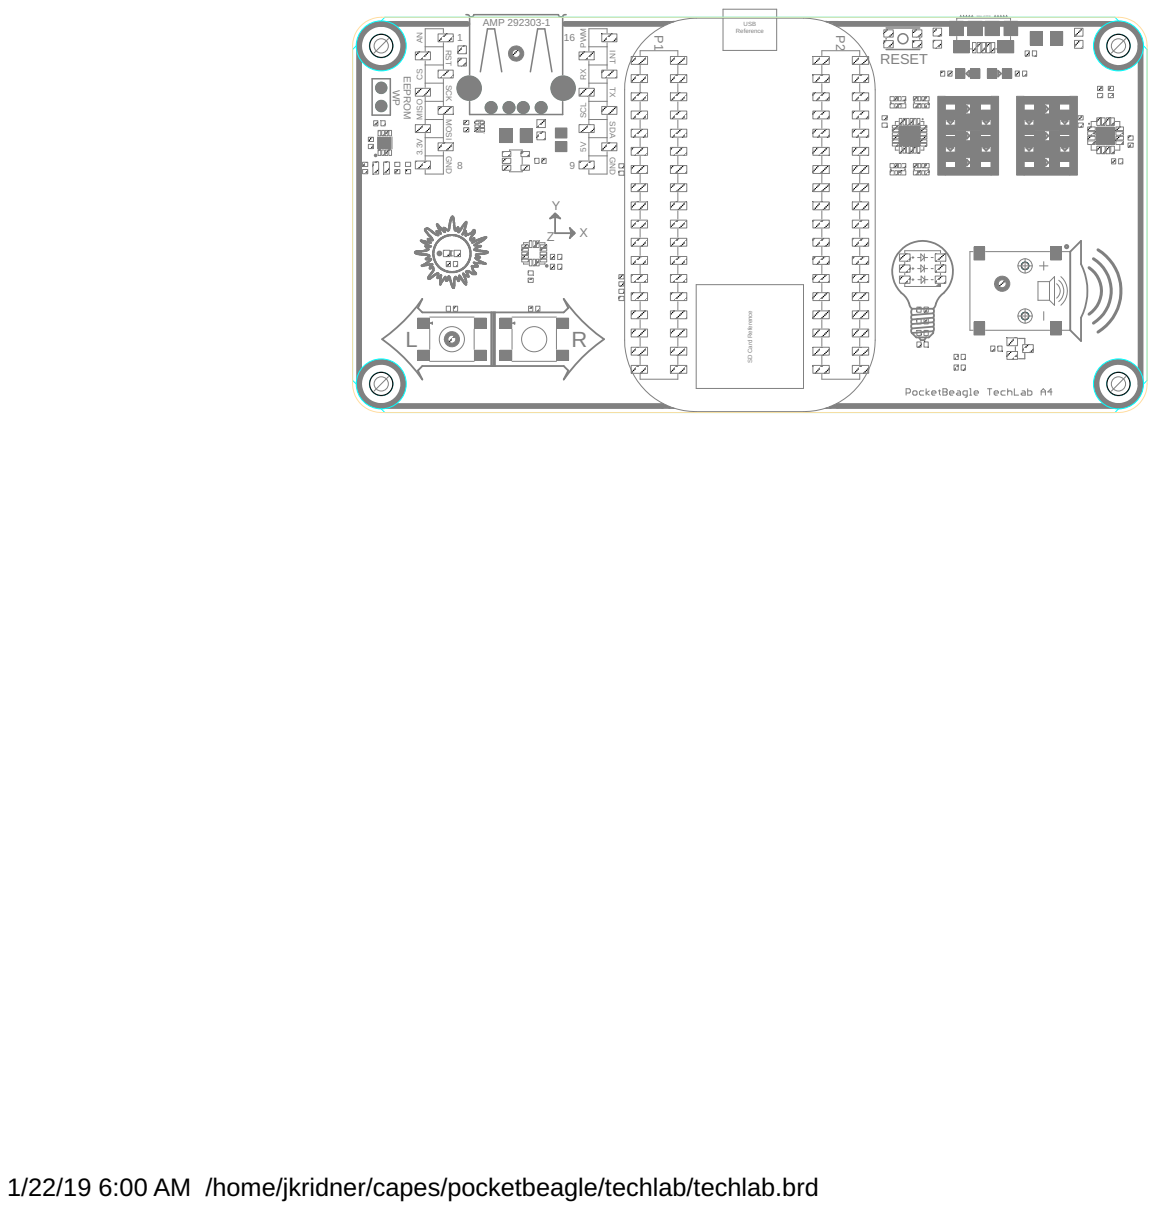
[picture p18: page 1]

SD Card Reference USB Reference AN

Edge of PCB AMP 292303-1

SCK MISO MOSI 3.3V GND

1/22/19 6:00 AM /home/jkridner/capes/pocketbeagle/techlab/techlab.brd
