beagleboard/capes/pocketbeagle/TechLab/TechLab_Cape_sch.pdf

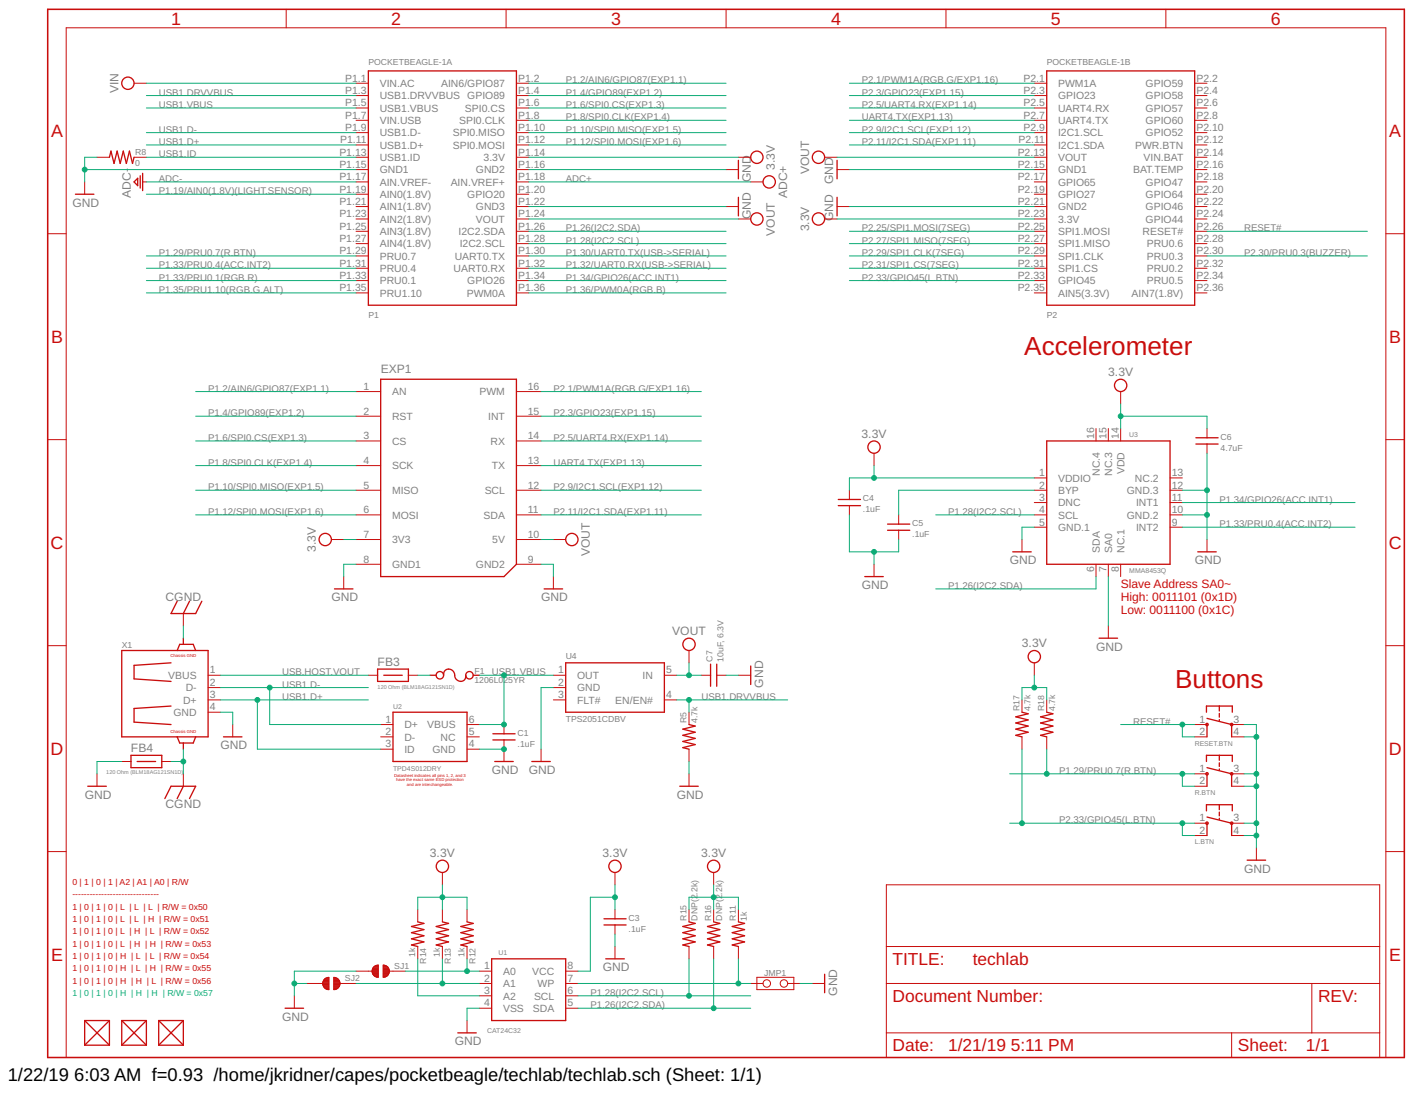
[picture p19: page 1]

VOUT VOUT GND GND

TPD4S012DRY
Datasheet indicates all pins 1, 2, and 3
have the exact same ESD protection
and are interchangeable.

1/22/19 6:03 AM f=0.93 /home/jkridner/capes/pocketbeagle/techlab/techlab.sch (Sheet: 1/1)

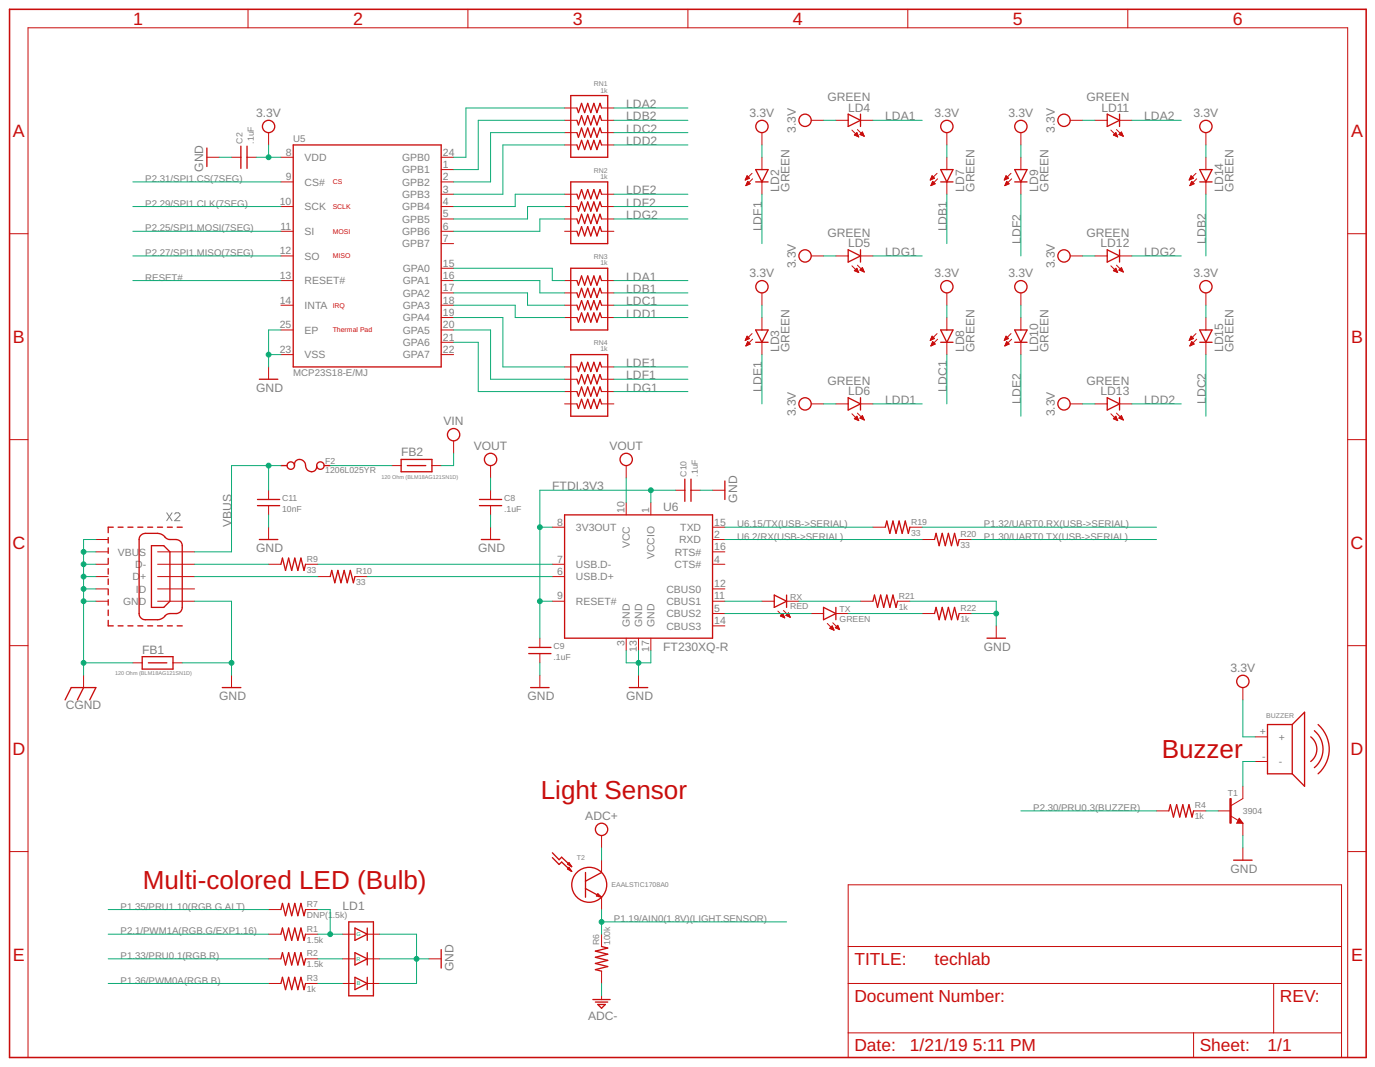
[picture p20: page 2]

GREEN GREEN GREEN GREEN GREEN

Multi-colored LED (Bulb)

Document Number: | REV:

Date: 1/21/19 5:11 PM | Sheet: 1/1
