beagleboard/capes/beaglebone/Power/Power_Cape_sch.pdf

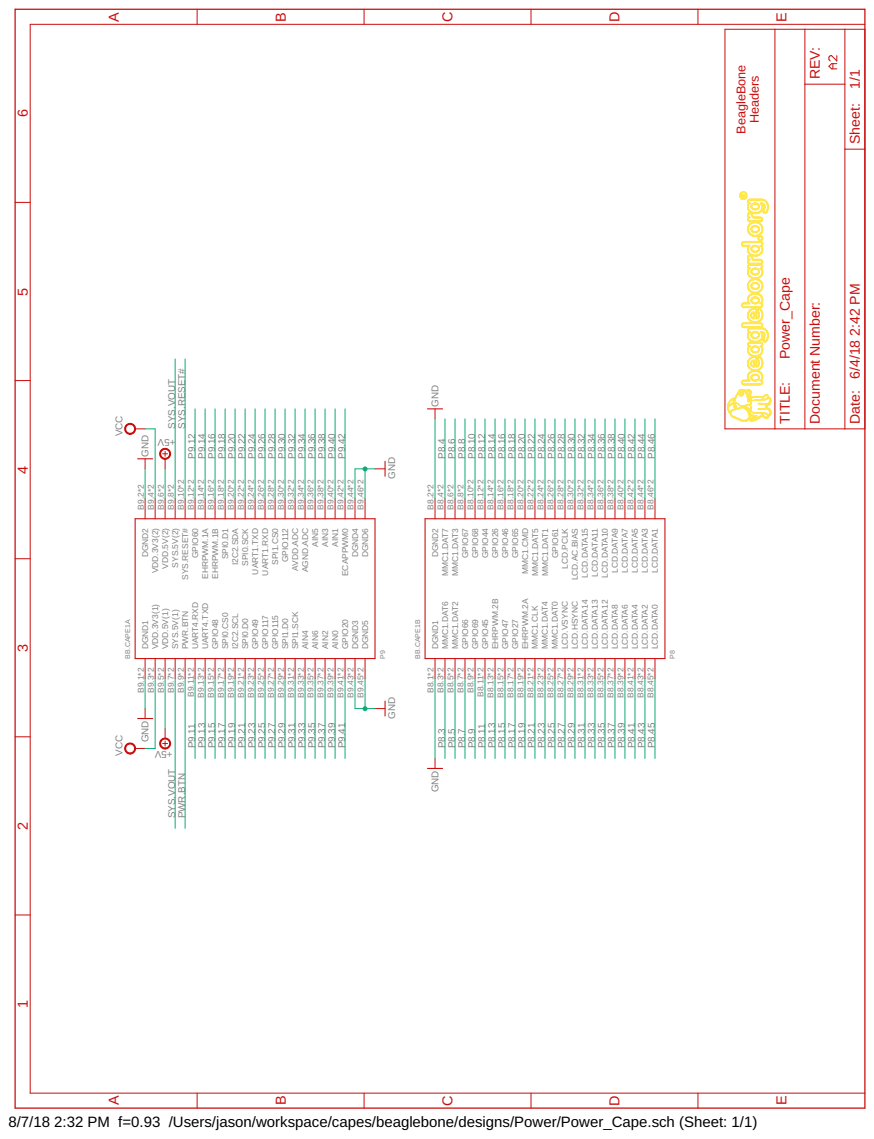
[picture p21: page 1]

BeagleBone Headers Power ICs and Header

REGULATED.3V3 SYS.VOUT SYS.VOUT SYS.VOUT PWR.BTN

SYS.RESET#

DGND1 B9.1*2 DGND2 B9.2*2 VDD.3V3(1) B9.3*2 VDD.3V3(2) B9.4*2 VDD.5V(1) B9.5*2 VDD.5V(2) B9.6*2 SYS.5V(1) B9.7*2 SYS.5V(2) B9.8*2 PWR.BTN

8/7/18 2:32 PM f=0.93 /Users/jason/workspace/capes/beaglebone/designs/Power/Power_Cape.sch (Sheet: 1/1)

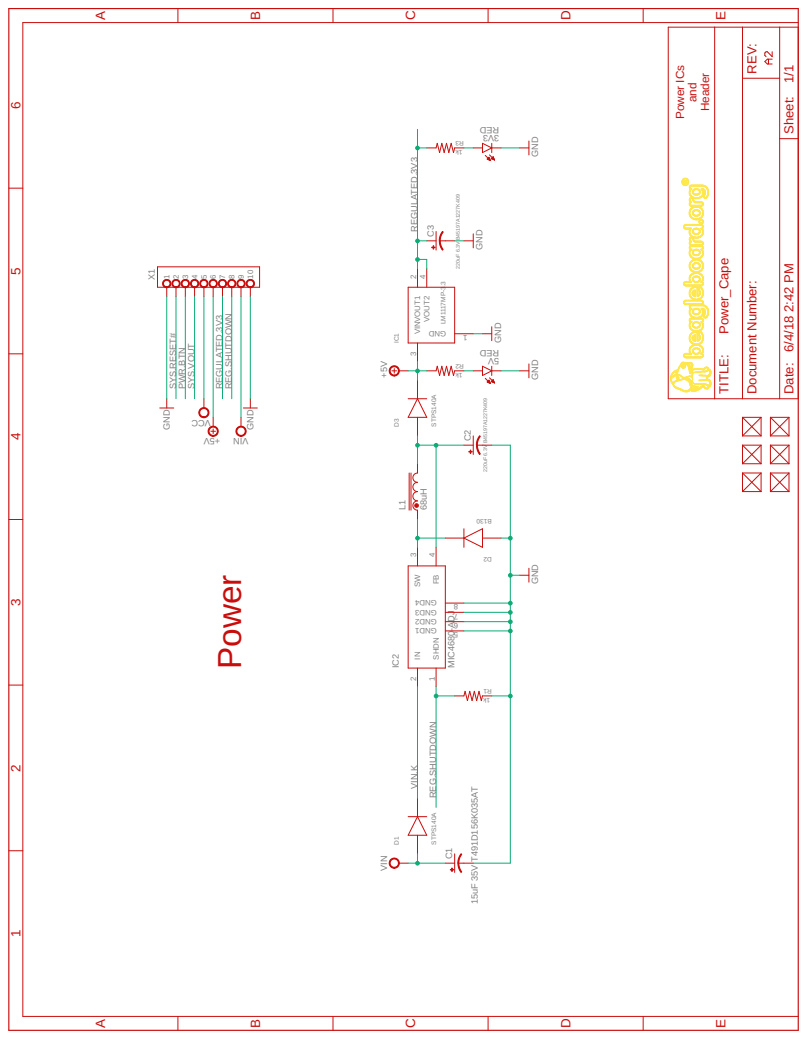
[picture p22: page 2]
