beagleboard/capes/beaglebone/Robotics/Robotics_Cape_brd.pdf

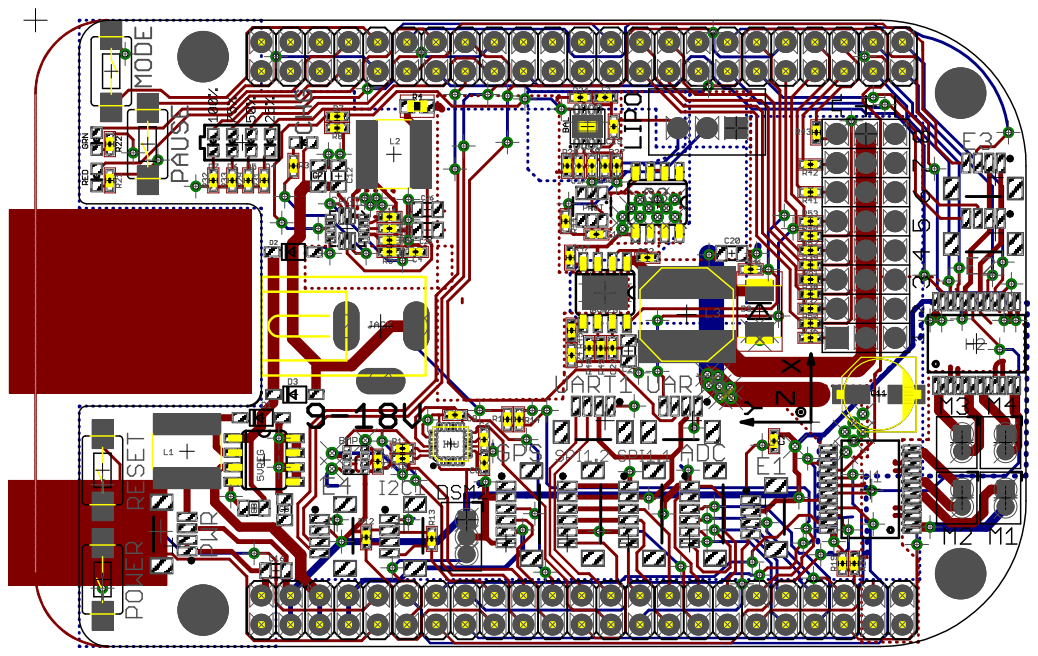
[picture p23: page 1]
