beagleboard/capes/beaglebone/Robotics/Robotics_Cape_sch.pdf

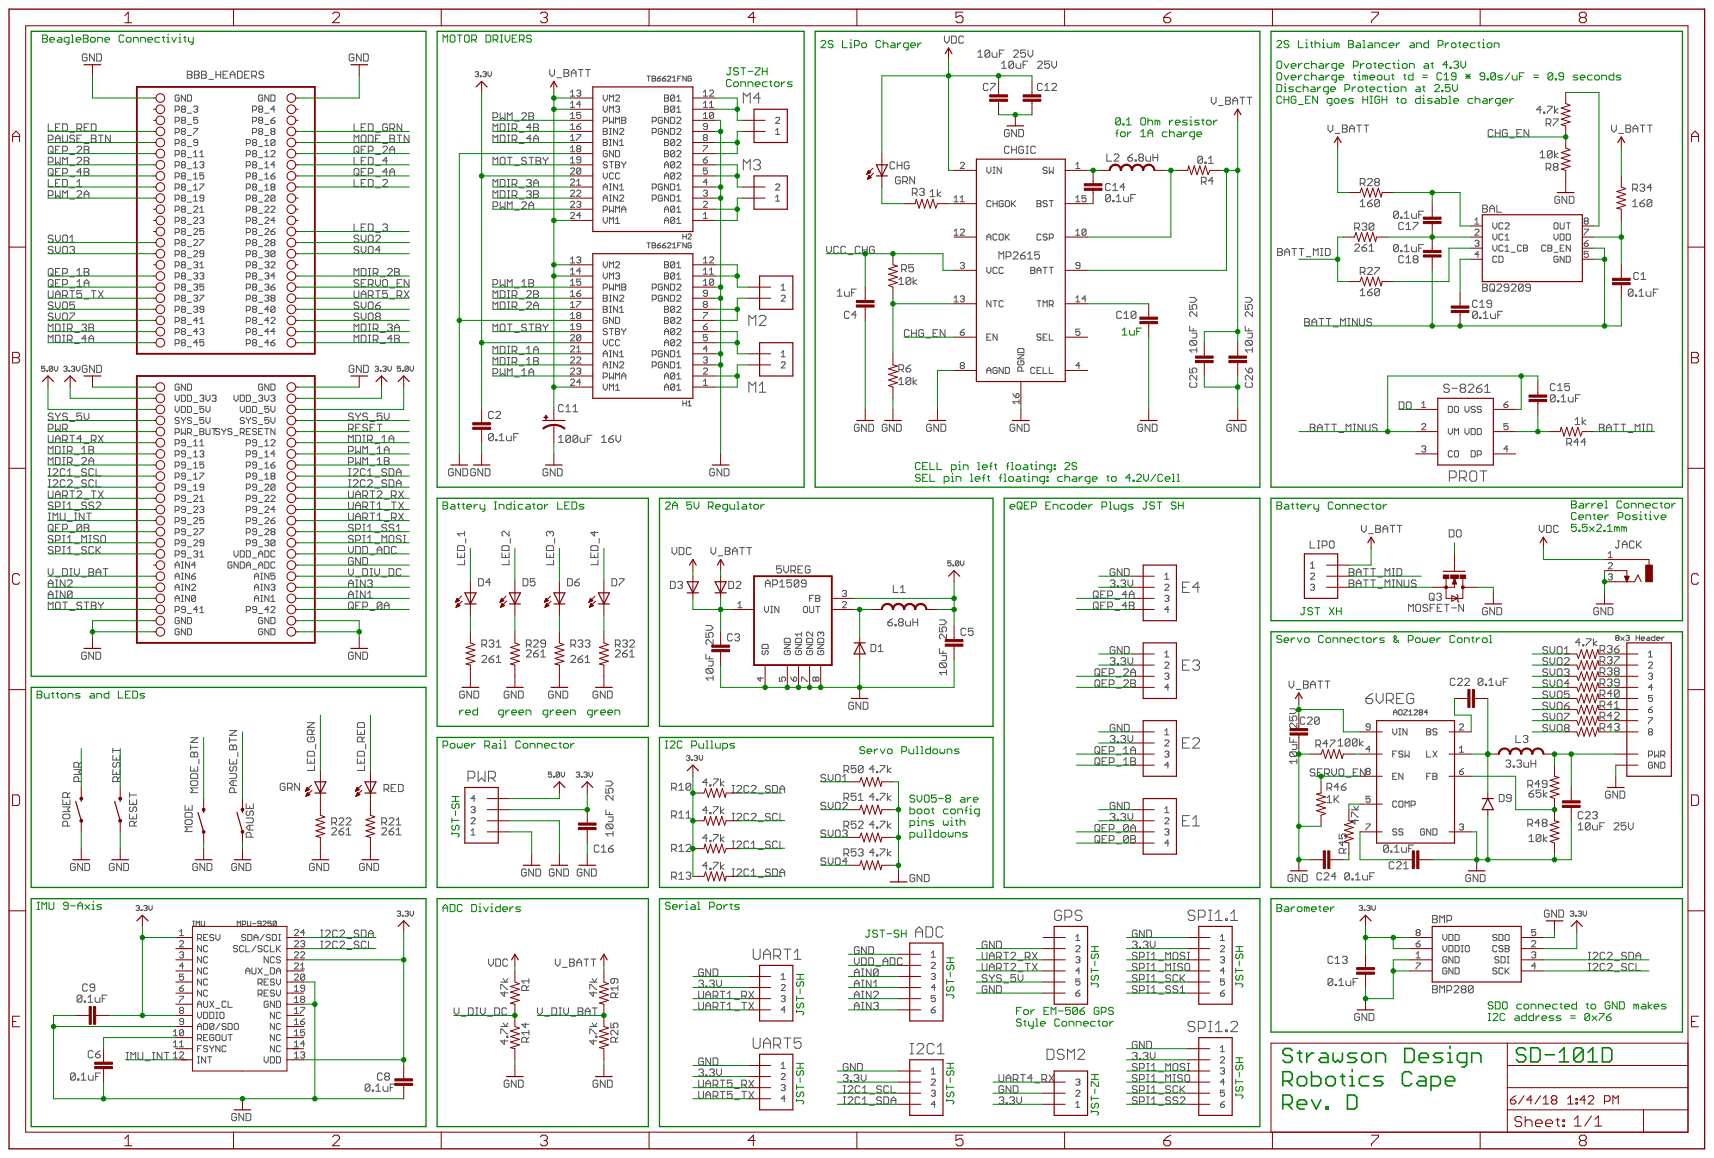
[picture p24: page 1]
