beagleboard/capes/beaglebone/Proto/Proto_Cape_brd.pdf

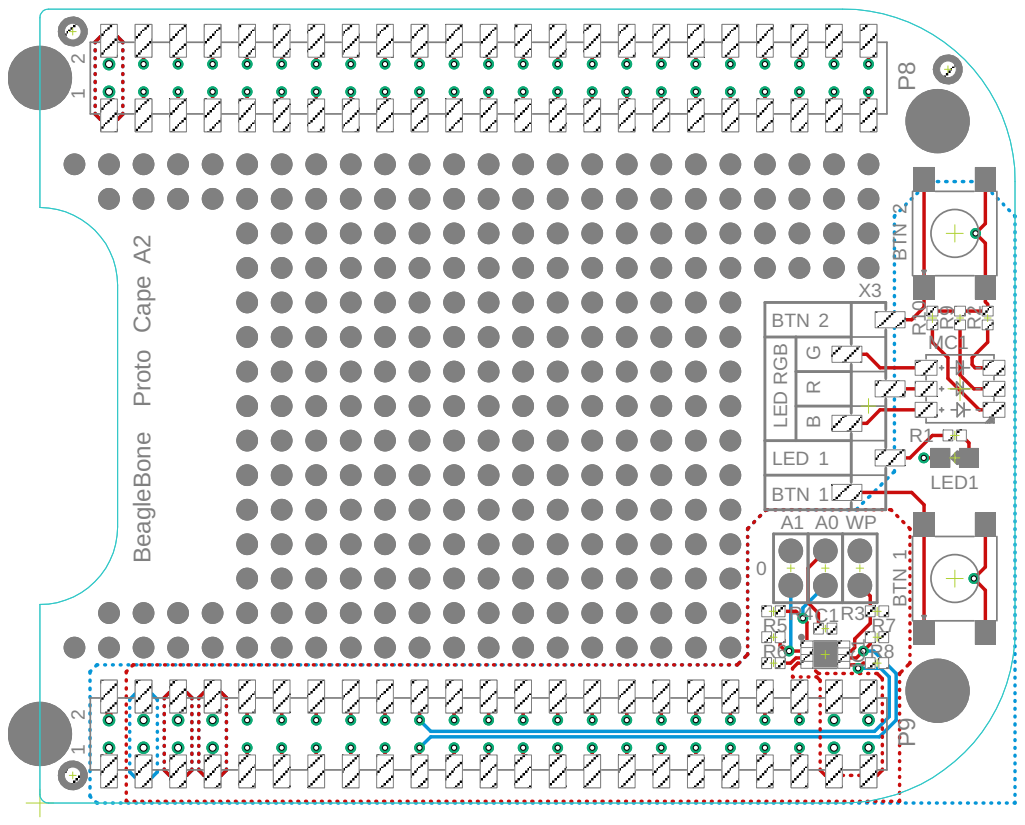
[picture p25: page 1]
