beagleboard/capes/beaglebone/Motor/Motor_Cape_brd.pdf

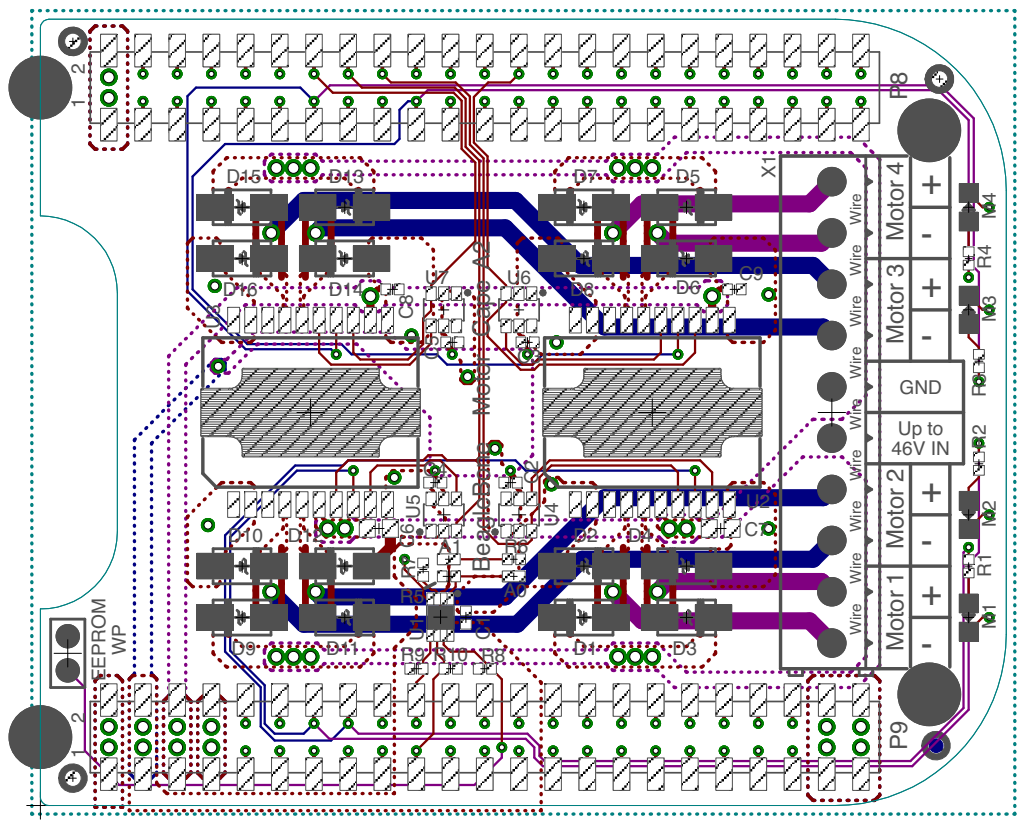
[picture p26: page 1]
