beagleboard/capes/(list of files, drawings)

Other design files:
pocketbeagle/Grove/Grove_Cape.DSN
