beagleboard/capes/(commit log)

2014-08-25 Initial Schematic and Pin Table
2014-09-06 swap pwm and motor direction pins
2014-09-19 Pin mapping update
2014-09-24 protection circuit
2014-09-24 resistor tweaks for availability
2014-09-28 ADC Breakout
2014-11-29 fixed SPI naming convention
2015-08-17 added revision D schematic
2015-08-18 6V regulator for servo power
2015-08-23 Update revision D schematic
2015-08-23 add header pin table and 3D Cad Model
    [SD-101D Robotics Cape 3D Model.SLDPRT, SD-101D Robotics Cape Header Pin Table .xlsx]
2015-10-09 fit schematic on 1 sheet
2016-04-07 update pin table swapping mdir2B and uart5rx
    [SD-101D Robotics Cape Header Pin Table .xlsx, SD-101D Robotics Cape Header Pin Table.xlsx]
2016-04-07 update schematic with swapped mdir2b & uart5rx
2016-07-02 naming continuity in schematic
2017-05-12 add full design and license
    [SD-101D Robotics Cape 3D Model.SLDPRT, SD-101D Robotics Cape Header Pin Table.xlsx, SD-101D Robotics Cape.brd, SD-101D Robotics Cape.sch, SD-101D_header_pin_table.ods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]
2017-10-18 Move Robotics Capes files for merge
    [Robotics_Cape.brd, Robotics_Cape.sch, SD-101D Robotics Cape 3D Model.SLDPRT, SD-101D_header_pin_table.ods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]
2017-10-18 Add GHI WIP capes
    [CAN_RS485_Cape.brd, CAN_RS485_Cape.sch, Display18_Cape.brd, Display18_Cape.sch, Display43_Cape.brd, Display43_Cape.sch, Display70_Cape.brd, Display70_Cape.sch]
2017-10-28 Add scripts directory and pins list
    Not yet sure what will go in here, but plan is to somehow have scripts to help automate the pin utilization documentation.
    [am335x-beagle-pins.csv]
2017-10-28 Sort on BeagleBone pin number
    [am335x-beagle-pins.csv]
2017-10-29 Add some pin entries and design issues
    [am335x-beagle-pins.csv]
2017-10-29 Convert to pin list to mediawiki table
2017-10-29 Fix some bad pin table indexes
    [am335x-beagle-pins.csv]
2017-10-30 Update pin list
    [am335x-beagle-pins.csv]
2017-10-30 Update pin table order
    [am335x-beagle-pins.csv]
2017-10-30 Transpose pin table and reorder
    [am335x-beagle-pins.csv]
2017-10-30 Add pin table format
2017-10-30 Add Relay Cape issues
    [am335x-beagle-pins.csv]
2017-10-30 Another pin table rewrite
    [am335x-beagle-pins.csv]
2017-10-30 Some pin table fixes
    [am335x-beagle-pins.csv]
2017-10-30 Move pin table to README.mediawiki
    [am335x-beagle-pins.csv]
2017-10-30 Remove old pin table and README
    [am335x-beagle-pins.csv]
2017-11-01 Add extra pin info for Aron
    [am335x-beagle-pins.csv]
2017-11-03 Fix Blue WIFI LED
    [am335x-beagle-pins.csv]
2017-11-05 More BeagleBone Blue fixes
    [am335x-beagle-pins.csv]
2017-11-06 Update Blue pins
    [am335x-beagle-pins.csv]
2017-11-08 Add more BSM balls
    [am335x-beagle-pins.csv]
2018-01-24 More updates than intended. Hope they are all right!
    [am335x-beagle-pins.csv]
2018-01-25 Added the revised EAGLE schematics. Also removed two files that were probably not intended to be added as they are lock files in EAGLE.
    [BeagleBone Comms Cape.brd, BeagleBone Comms Cape.sch, Display18_Cape.brd, Display18_Cape.sch, Display50_Cape.brd, Display50_Cape.sch, Display70_Cape.brd, Load_Cape.sch]
2018-01-25 Rename boards and delete pdfs for now
    [BeagleBone Comms Cape.brd, BeagleBone Comms Cape.sch, Comms_Cape.brd, Comms_Cape.sch, Display50_Cape.brd, Display50_Cape.sch, Display50_Cape_update.brd, Display50_Cape_update.sch]
2018-01-25 Remove merge inputs for Display50
    [Display50_Cape_update.brd, Display50_Cape_update.sch]
2018-01-25 README.mediawiki: update paths
    [am335x-beagle-pins.csv]
2018-01-25 README.mediawiki: update IDs
    [am335x-beagle-pins.csv]
2018-01-25 Update Load Cape pins on README
    [am335x-beagle-pins.csv]
2018-04-20 Add PDF for Motor Cape
2018-04-20 New subdirectories
    [Comms_Cape.brd, Comms_Cape.sch, Display18_Cape.brd, Display18_Cape.sch, Display50_Cape.brd, Display50_Cape.sch, Display70_Cape.brd, Display70_Cape.sch]
2018-05-07 Another directory rename
    [Comms_Cape.brd, Comms_Cape.sch, Display18_Cape.brd, Display18_Cape.sch, Display50_Cape.brd, Display50_Cape.sch, Display70_Cape.brd, Display70_Cape.sch]
2018-08-07 Power Cape: add PDF schematic
2018-08-08 Add PDF schematic for Robotics Cape
2018-10-01 Move files yet again
    [Comms_Cape.brd, Comms_Cape.sch, Display18_Cape.brd, Display18_Cape.sch, Display50_Cape.brd, Display50_Cape.sch, Display70_Cape.brd, Display70_Cape.sch]
2019-01-22 Add TechLab
    [techlab.brd, techlab.sch]
2019-01-22 TechLab: update name and add PDFs
    [TechLab_Cape.brd, TechLab_Cape.sch]
2019-02-22 Add schematic PDFs
2019-02-26 GamePup: added
    [GamePup_Cape.brd, GamePup_Cape.sch]
2019-03-12 Removing Display50
    [Display50_Cape.brd, Display50_Cape.sch]
2019-07-18 GamePup: update to A4
    [GamePup_Cape.brd, GamePup_Cape.sch]
2020-05-30 Add PocketBeagle Grove Cape
    [Grove_Cape.DSN]
2025-04-06 Try converting TechLab to KiCAD
    [TechLab.kicad_pcb, TechLab.kicad_sch, TechLab_Cape.brd, TechLab_Cape.sch]
2025-04-23 Convert Techlab to multisheet schematic
    [TechLab.kicad_sch, TechLab_Page2.kicad_sch, TechLab_page1.kicad_sch]
2025-04-23 TechLab: fix some silkscreen orientations
    [TechLab.kicad_pcb]
2025-04-23 TechLab: update revision to A5
    [TechLab.kicad_pcb]
2025-04-23 TechLab: Update title block for cleaner print
    [TechLab.kicad_sch, TechLab_Page1.kicad_sch, TechLab_Page2.kicad_sch]
2025-04-23 CI: fix path to schematic for package
2025-04-23 TechLab: fill copper zones
    [TechLab.kicad_pcb]
2025-04-23 TechLab: fix some DRCs
    [TechLab.kicad_pcb]
2025-05-04 Add USB C and 3-pin JST SH for UART with analog switch
    [TechLab.kicad_pcb, TechLab.kicad_sch, TechLab_Page1.kicad_sch, TechLab_Page2.kicad_sch]
2025-05-05 CI: use 9.0 Kicad
2025-05-05 TechLab: back-annotate BOM
    [TechLab_Page1.kicad_sch, TechLab_Page2.kicad_sch]
2025-05-05 CI: fix BOM fields
    [TechLab_Page1.kicad_sch]
2025-05-05 TechLab: hide MANUFACTURER and MPN
    [TechLab_Page1.kicad_sch]
2025-05-05 TechLab: fix comment
    [TechLab_Page1.kicad_sch]
2025-05-05 TechLab: hide MANUFACTURER/MPN
    [TechLab_Page2.kicad_sch]
2025-05-05 TechLab: reannotate PCB from schematic
    [TechLab.kicad_pcb]
2025-05-05 TechLab: fix some reference designators
    [TechLab.kicad_pcb, TechLab_Page1.kicad_sch, TechLab_Page2.kicad_sch]
2025-05-06 TechLab: BOM and RefDes updates
    [TechLab_Page1.kicad_sch, TechLab_Page2.kicad_sch]
2025-05-06 TechLab: RefDes and other cleanup, still needs forward annotation of PCB
    [TechLab.kicad_pcb, TechLab_Page1.kicad_sch, TechLab_Page2.kicad_sch]
2025-05-06 TechLab: add some missing nets to schematic symbols
    [TechLab_Page1.kicad_sch, TechLab_Page2.kicad_sch]
2025-05-06 TechLab: restore some accidentally removed descriptions
    [TechLab_Page1.kicad_sch, TechLab_Page2.kicad_sch]
2025-05-06 TechLab: more cleanup
    [TechLab.kicad_pcb, TechLab_Page1.kicad_sch, TechLab_Page2.kicad_sch]
2025-05-06 TechLab: forward-annotated to PCB with errors
    [TechLab.kicad_pcb]
2025-05-06 TechLab: fix most ERCs
    [TechLab.kicad_pcb, TechLab_Page1.kicad_sch, TechLab_Page2.kicad_sch]
2025-05-06 TechLab: cleared most DRCs
    [TechLab.kicad_pcb]
2025-05-06 TechLab: minor silkscreen updates
    [TechLab.kicad_pcb]
2025-05-06 TechLab: update silkscreen and power trace
    [TechLab.kicad_pcb]
2025-05-06 TechLab: ideas for replacements to buzzer and light sensor
    [TechLab_Page2.kicad_sch]
2025-05-07 TechLab: alternate buzzer
    [TechLab_Page2.kicad_sch]
2025-05-07 TechLab: hack, add second footprint for P1
    [TechLab.kicad_pcb]
2025-05-07 Fix warnings and mounting holes
    [TechLab.kicad_pcb]
2025-05-07 Divide P1 and P2 cape headers
    [TechLab.kicad_pcb, TechLab_Page1.kicad_sch]
2025-05-08 TechLab: fix BUZZER label
    [TechLab.kicad_pcb]
2025-05-08 TechLab: minor update, move labels
    [TechLab_Page1.kicad_sch, TechLab_Page2.kicad_sch]
2025-05-08 TechLab: realign schematic with PCB
    [TechLab.kicad_pcb, TechLab_Page2.kicad_sch]
2025-05-08 Split mikroBUS port
    [TechLab.kicad_pcb, TechLab_Page1.kicad_sch]
2025-05-08 Add pinout silkscreen Button, LED, and Buzzer
    [TechLab.kicad_pcb]
2025-05-08 TechLab: extend silkscreen
    [TechLab.kicad_pcb]
2025-05-08 TechLab: started adding more part bodies, but taking too long
    [TechLab.kicad_pcb]
2025-05-08 TechLab: back-annotate parts
    [TechLab.kicad_pcb, TechLab_Page1.kicad_sch]
2025-05-17 Add LiPo battery connector
    [TechLab.kicad_pcb, TechLab_Page1.kicad_sch]
2025-05-17 Update silkscreen with I2C device address
    [TechLab.kicad_pcb]
2025-05-20 TechLab: incorporate feedback from Kathy Giori
    [TechLab.kicad_pcb]
2025-05-20 TechLab: more silkscreen updates based on feedback
    [TechLab.kicad_pcb]
2025-06-26 probably should not check in gerbers or other generated files
    [TechLab-B_Cu.gbr, TechLab-B_Mask.gbr, TechLab-B_Paste.gbr, TechLab-B_Silkscreen.gbr, TechLab-Edge_Cuts.gbr, TechLab-F_Cu.gbr, TechLab-F_Mask.gbr, TechLab-F_Paste.gbr]
2025-10-21 Fix 3pin JST SH 1.00 port pinout
    [TechLab.kicad_pcb, TechLab_Page1.kicad_sch, TechLab_Page2.kicad_sch]
2025-10-21 Add pin numbers on front silkscreen
    [TechLab.kicad_pcb]
2025-11-11 Update SPI line names and confirm BOM
    [TechLab.kicad_pcb, TechLab_Page1.kicad_sch, TechLab_Page2.kicad_sch]
2026-03-16 Move LiPo Battery Connector for lower height header pins
    JST PH 2.00mm connector when kept in center collides with JST SH 1.00mm connector on PocketBeagle 2 thus it needs to be shifted to avoid collision.
    [TechLab.kicad_pcb]
